Konkery/Project-8_2026-N2-HORIZON/03__Проект/ai-8_2026-n2-горизонт.md

# ЖУРНАЛ ПРОЕКТА 8/2026-N2-ГОРИЗОНТ

> **Назначение.** Append-only журнал работ сессии заказа **N2** рамочного договора
> `8/2026-N0-ГОРИЗОНТ`. Записи хронологически вниз; прошлые опечатки не правятся.
> Системный контекст: `..\..\8_2026-N0-Горизонт\AGENTS.md` (манифест рамки) +
> переходный промт `03__Проект\00__raw\ai-trans-order2.md`.
> Регламент ведения — манифест § 4 (по аналогии с журналом рамки
> `03__Проект\ai-8_2026-n0-горизонт.md`).

---

## 1. Промты

### 1.1 Переходный промт заказа N2 (перенос контекста из рамки 8/2026-N0)

#### _исходные данные:_

Сессия рамки `8/2026-N0-ГОРИЗОНТ` накопила полный контекст преддоговорной и
договорной работы (промты 0.1–1.10). Рамочный договор подписан исполнителем
20.10.2026 (ЭДО, версия заказчика `rev.01 v02` подписана ЭП 20.10.2026).
Работа по прикладным заказам переносится в директорию `8_2026-N2-Горизонт\`.
Переходный промт с полным перенесённым контекстом сохранён:
`03__Проект\00__raw\ai-trans-order2.md`.

#### _задача:_

1. Принять контекст рамки (манифест + переходный промт) как базовый системный
   контекст сессии заказа N2;
2. Завести настоящий журнал; далее вести работу заказа N2 в его директории,
   обращаясь к рамке N0 только за мастер-данными и документами общего цикла.

### 1.2 Создание манифеста заказа N2 (`AGENTS.md`)

#### _исходные данные:_

В директории заказа N1 уже сформирован манифест `..\8_2026-N1-Горизонт\AGENTS.md`
(v2.0) по образу манифеста рамки. Для заказа N2 собственный манифест отсутствует —
сессия опиралась только на манифест рамки и переходный промт.

#### _задача:_

Изучить переходный промт `03__Проект\00__raw\ai-trans-order2.md` и фактическое
содержимое ИРП заказа; создать `AGENTS.md` в корне `8_2026-N2-Горизонт\` по образу
и подобию манифеста рамки N0 (структура — как в манифесте N1), адаптировав под
специфику N2.

### 1.3 Актуализация план-графика и фиксация проекта в git (указание стороны)

#### _задача:_

1. Актуализировать `03__Проект\03__План-график\План_проекта_8_2026-N2_Horizon_VM.md`
   (120 к.д., ООО «ТМ ТЕХНОЛОГИЯ») — снять задачу 🎯 из манифеста § 9;
2. Выполнить коммит и push: все текущие файлы заказа должны отслеживаться
   (учитывая конвенции `.gitignore` и практики репозитория N1).

### 1.4 Фиксация подписания спецификации N2 и поступления аванса 1 (21.10.2026)

#### _исходные данные:_

Вечером 21.10.2026 (после 21:00) спецификация № 2 к рамочному договору подписана
со стороны исполнителя через ЭДО (версия заказчика подписана ЭП 20.10.2026
14:29 MSK; сверка версий выполнена 20.10.2026 — юридически значимых расхождений
нет, акцепт дословный). Ориентировочно в 12:00 (самарское время) 21.10.2026 по
счёту №2 от 20.10.2026 получен авансовый платёж 1 (55%).

#### _задача:_

1. Зафиксировать в проектной документации: с 21.10.2026 формально наступило
   время обязательств исполнителя по заказу N2 (День 0);
2. Синхронизировать статусы манифеста (§ 1.1, § 9) и план-графика (календарная
   привязка от Дня 0);
3. Коммит и push не выполнять — фиксация в git при более существенных изменениях
   (указание стороны).

### 1.4.1 Примечание к промту 1.4 (уточнение стороны от 21.10.2026)

Коммит и push по настоящей фиксации не выполняются — решение отложено до более
существенных изменений (указание Хозяина).

### 1.5 Разворачивание регламента переписки в проекте (26.10.2026)

#### _исходные данные:_

Сторона направила (двумя идентичными блоками) промт «ПЕРЕПИСКА В ПРОЕКТЕ»:
единое хранение `01__Документация\Переписка\` с каталогами `01__Входящие`,
`02__Исходящие`, `03__Третьи лица`, `04__Не официальная`; в каждом — `00__draft\`
для драфтов (по умолчанию markdown `…-draft.md`), выпущенный на бланке экземпляр —
в корень каталога; заглушки `README-mail-*.md` — реестры писем
(`Дата | Исх. № / файл | Тема письма | Контрагент | Статус`), хранящие реестровые
данные **единственно** в себе (в README/манифест — только путь); обязательная строка
`Тема письма:` под блоком реквизитов; агент готовит содержательную часть с
заглушками, человек — бланк/номер/ФИО/подпись; даты и суммы — только из
подписанных документов по первоисточнику; агент не выдумывает даты/номера
(без факта — статус «черновик»); цикл драфт → выпуск → подтверждение менеджера →
реестр → журнал; этика закрытой тематики и ролевых формулировок.

#### _задача:_

1. Развернуть структуру и реестры в заказе N2 с постановкой на учёт уже
   присутствующего выпущенного экземпляра исходящего письма;
2. Кодифицировать регламент в манифест `AGENTS.md` (связки § 7, новый § 10);
3. Зафиксировать факт в настоящем журнале; коммит/push — по отдельному указанию.

### 1.6 Драфт уведомления «О старте работ» для заказчика (26.10.2026)

#### _исходные данные:_

Указание стороны: подготовить информационное письмо заказчику о получении
аванса на р/с и приступлении к работам. Текст — по аналогии с заказом N1
(шаблон в промте: благодарность за подписание спецификации, зачисление аванса 1
с суммой и ссылкой на счёт/п. У.3.1, формулировка предмета работ, срок по п. У.7
календарными днями с датировкой финиша, напоминание об окне поставки образца
по п. У.4 с формой М15, уведомление об этапах по п. У.8). Имя файла драфта
задала сторона: `уведомление-начало-работ-draft.md`.

#### _задача:_

1. Перепроверить каждую цифру/пункт по первоисточнику — подписанному тексту
   Спецификации № 2 (п. 10 регламента § 10 манифеста);
2. Создать драфт в `01__Документация\Переписка\02__Исходящие\00__draft\`
   с блоком реквизитов-заглушек и строкой `Тема письма:`;
3. Внести строку в реестр `README-mail-out.md` со статусом «черновик»;
   закрыть часть задачи 8 § 9 манифеста (подготовка исправленного текста);
4. Запись в журнал; коммит/push — не выполнять.

### 1.7 Фиксация отправки письма М1, актуализация документации, git-фиксация (26.10.2026)

#### _исходные данные:_

Сторона сообщила: письмо «О старте работ» (Исх. № 8/2026-N2-Горизонт-M1 от
26.10.2026, PDF на бланке в корне `02__Исходящие\`) **отправлено через ЭДО**.
Проверка готового экземпляра по первоисточнику выполнена 26.10.2026 (по
указанию стороны): финансовые показатели верны (аванс 1 964 200,00 ₽,
НДС 354 200,00, счёт № 2 от 20.10.2026, п. У.3.1 Спец. № 2); модель
Knowhy G80/master корректна; зафиксировано расхождение написания модели ПТК
(«Horizon VM Post M80 rev.01» в письме против дословного
«HorizonVM Post M80 rev1» в спецификации) и отсутствие абзацев У.7/У.4/У.8
в отправленной версии; прежний docx-экземпляр с данными заказа N1 заменён.

#### _задача:_

1. Реестр `README-mail-out.md`: PDF — статус «отправлено» с датой; docx —
   «отозван»; драфт — снять с выпуска (отправлена сокращённая версия);
2. Манифест: задача 8 → ✅, версия 1.3;
3. Подготовить информативный коммит (включая перестройку ИРП стороной:
   реестр писем, каталог «ТМ Технология», закрытие старого блока
   «Точные машины», счета) и выполнить push.

---

## 4. Тема - Исполнение промтов (заказ N2)

### 4.1 Запись от 20.10.2026 — инициализация журнала заказа N2

#### _Ход работы:_

Создан переходный промт `03__Проект\00__raw\ai-trans-order2.md` (перенос
контекста цепочки заказов N1–N7, решений №1/№2, системы спецификаций, экономики
и статусов по состоянию на 20.10.2026) и настоящий журнал.

#### _Решение:_

1. журнал — append-only, структура повторяет журнал рамки (разделы промтов и
   записей исполнения);
2. ключевые зафиксированные факты переноса: рамочный договор подписан
   исполнителем 20.10.2026; заказчик — ООО «ТМ ТЕХНОЛОГИЯ» (все заказы N1–N7
   для него); подписание N1/N2/N3 одновременное через ЭДО.

#### _Проверки:_

Файлы созданы; пути переходного промта и журнала соответствуют ИРП заказа.

### 4.2 Запись от 20.10.2026 — создан манифест заказа N2

#### _Ход работы:_

Прочитаны: манифест рамки `..\8_2026-N0-Горизонт\AGENTS.md` (v1.8), переходный
промт `03__Проект\00__raw\ai-trans-order2.md`, журнал заказа, манифест-аналог
заказа N1 (`..\8_2026-N1-Горизонт\AGENTS.md`, v2.0) как шаблон структуры.
Проведена инвентаризация фактического содержания ИРП N2 (спецификации типов
30/40 и рабочие срезы 50–90, ТКП на ООО «ТМ ТЕХНОЛОГИЯ», счета, план-график,
ИД-материалы Wate, материалы контрагентов), проверен git-репозиторий заказа.

Создан `AGENTS.md` (корень `8_2026-N2-Горизонт\`), v1.0: § 1 паспорт заказа и
экономика (5 позиций, 120 к.д., 2 960 000,00 ₽ без НДС; аванс 1/2 и постоплата),
§ 2 роли/диалог/этика, § 3 система спецификаций, § 4 регламент разработки,
§ 5 дорожная карта и увязки (N2 → N3, перспективный N5), § 6 регламент
бизнес-процесса, § 7 реестр ИРП, § 8 внешние ссылки, § 9 статус и задачи.

#### _Решение:_

1. Структура и нормы наследуются от манифеста рамки; при расхождении приоритет —
   у манифеста рамки (§ назначение документа);
2. В § 1.2 добавлен callout о первичности абсолютных сумм платежей и о сверке
   реквизитов заказчика (расхождения подписанной v02);
3. В § 7 зафиксированы фактические артефакты, в том числе счёт №2 от 20.10.2026
   на ООО «ТМ ТЕХНОЛОГИЯ» (аванс 1) и ТКП sign/nosign;
4. В § 9 поставлена отдельная задача актуализации план-графика: текущая редакция
   `План_проекта_8_2026-N2_Horizon_VM.md` — 100 к.д. и прежний заказчик
   (ООО «Точные машины»), тогда как срок договора N2 — 120 к.д. от подписания.

#### _Проверки:_

`AGENTS.md` создан в корне заказа (160 строк по образцу N1); таблицы имеют
маркеры выравнивания; пути перепроверены по факту инвентаризации каталогов;
журнал дополнен записями 1.2 и 4.2 (append-only, исторические записи не
переписывались). Файлы спецификаций не изменялись (только чтение).

### 4.3 Запись от 20.10.2026 — актуализация план-графика и git-фиксация

#### _Ход работы:_

План-график переработан в редакцию rev.01 v02: срок 120 к.д. от даты подписания
(День 0), заказчик — ООО «ТМ ТЕХНОЛОГИЯ», основание — Решение №2 от 19.10.2026;
диаграмма Ганта пересобрана (Фаза 0 контрактация/аванс 1 1 964 200,00 ₽ с НДС;
Фаза 3 расширена до дней 95–118; Фаза 4 — постпроект), суммы платежей по
спецификации (аванс 1 — 1 610 000,00; аванс 2 — 1 000 000,00; постоплата —
350 000,00 без НДС); персоналии в матрице ответственности заменены ролевыми
формулировками (этика § 1.1); добавлен риск по реквизитам v02.

Манифест § 9: задача 3 → ✅. Git: `.gitignore` синхронизирован с практикой
репозитория N1; в индекс добавлены рабочие артефакты (типы 30/40, ТКП на
ТМ Технология, счета №2, ИД Wate (pdf), журнал, AGENTS.md, эскизы и документация
контрагентов); удалённые из рабочего дерева артефакты прежнего контрагента
сняты с отслеживания; переименование `ид-аппаратов-watt → wate` зафиксировано
как rename. Переходный промт остаётся в `00__raw/` вне git (правило `00__raw/`
в `.gitignore`, конвенция N1). Коммит с подробным сообщением, push в `origin main`.

#### _Решение:_

1. Спецификационные и платёжные артефакты фиксируются в git; рабочие каталоги
   `.*/`, `00__raw/` и медиа-фильтры (dwg/png/jpg/svg/mdb/dat/bak/mp4 и пр.) —
   по конвенции `.gitignore` репозитория-брата N1 (исторически коммитились до
   введения фильтров, новые выпуски не добавляются в обход фильтров);
2. Календарная привязка этапов — относительная (дни от Дня 0), до фиксации
   точной даты подписания N2 через ЭДО.

#### _Проверки:_

`git status` — рабочее дерево после коммита чисто (кроме игнорируемого);
`git push` — успешно (см. факт вывода); план-график читается, mermaid
gantt без синтаксических ошибок; суммы сверены с § 1.2 манифеста
(1 610 000,00 + 1 000 000,00 + 350 000,00 = 2 960 000,00 — сходится).

### 4.4 Запись от 21.10.2026 — подписание спецификации N2 и поступление аванса 1

#### _Ход работы:_

Зафиксировано: 21.10.2026 вечером (после 21:00) спецификация № 2 (заказ N2)
подписана со стороны исполнителя через ЭДО; версия заказчика подписана ЭП
директора 20.10.2026 14:29 (MSK), сверка версий — акцепт без юридически
значимых правок (см. сверку 20.10.2026). Ориентировочно в 12:00 самарского
времени 21.10.2026 получен авансовый платёж 1 по счёту №2 от 20.10.2026
(1 964 200,00 ₽ с НДС: база 1 610 000,00 + НДС 354 200,00).

Обновлены: манифест `AGENTS.md` (§ 1.1 строка подписания; § 9 — задачи 1/2/3
в текущих статусах, новая задача 6 старт исполнения, задача 7 ⚠️ по сроку);
план-график (календарная привязка от Дня 0 = 21.10.2026); настоящий журнал.

#### _Решение:_

1. **С 21.10.2026 формально наступило время обязательств исполнителя по заказу
   N2** — точка отсчёта (День 0) для целей планирования; фактические триггеры
   сроков по тексту спецификации: У.3 (аванс 1 в течение 3 раб. дней — исполнен
   поступлением), У.4 (передача образца заказчиком: окно 21–45 к.д. от зачисления
   аванса = ориентировочно 11.11–05.12.2026), У.7 (общий срок 140 к.д. с даты
   зачисления аванса 1 → ориентир завершения ~10.03.2027);
2. ⚠️ Выявлено при фиксации: срок по подписанной спецификации У.7 — **140 к.д.**,
   договорные сводные данные заказа (переходный промт, финансовая сводка цепочки) —
   **120 к.д.** Приоритет — у текста подписанной спецификации; расхождение
   эскалировано инженеру/стороне (в переписке — нейтральной формулировкой
   «уточнение исчисления срока»), в планировании до уточнения считать 140 к.д.;
3. Аванс 2 (33%, 1 220 000,00 ₽ с НДС) — в течение 30 календарных дней после
   подписания спецификации и выписки счёта (У.3 п.2) → ориентир до ~20.11.2026;
   контроль поступления;
4. Коммит/push не выполнялись (указание стороны); изменения в рабочем дереве.

#### _Проверки:_

Суммы сверены с текстом подписанной спецификации (У.3: 1 964 200 / 1 220 000 /
427 000 с НДС, Σ = 3 611 200,00 — сходится); даты-ориентиры вычислены от
21.10.2026 (21 к.д. → 11.11; 45 к.д. → 05.12; 140 к.д. → 10.03.2027;
подписание+30 к.д. → 20.11); файлы: `AGENTS.md` (2 правки секций), план-график
(привязка Дня 0), журнал (записи 1.4, 1.4.1, 4.4) — изменены; git-индекс не
трогался (`git status` — изменения в рабочем дереве, коммитов нет).

### 4.5 Запись от 26.10.2026 — развернут реестровый контур переписки

#### _Ход работы:_

Структура переписки заказа развернута по регламенту стороны (промт 1.5) и по
образу реестров репозитория-брата N1 (прочитаны `README-mail-in.md`,
`README-mail-out.md` N1). В `01__Документация\Переписка\` созданы четыре каталога
с заглушками-реестрами — `README-mail-in.md`, `README-mail-out.md`,
`README-mail-third.md`, `README-mail-unofficial.md` — и подкаталоги `00__draft\`
в каждом.

Принят на учёт ранее выпущенный экземпляр в `02__Исходящие\`: Исх. №
8/2026-N2-Горизонт-M1 от 26.10.2026, тема «О старте работ», контрагент
ООО «ТМ Технология» — внесён в реестр со статусом «выпущен (отправка не
подтверждена)». Текст письма прочитан через копию `%TEMP%` (оригинал занят
сессией Word): указаны счёт № 1, Спецификация № 1, аванс 1 543 700,00 ₽
(НДС 278 372,13) и старт работ по Заказу № 1 — это данные заказа N1;
для заказа N2 корректные: счёт № 2 от 20.10.2026, Спецификация № 2,
аванс 1 964 200,00 ₽ с НДС.

Манифест `AGENTS.md` дополнен: § 7 (строка ИРП `01__Документация/` — путь
к реестрам), § 9 (задача 8 ⚠️ — подтверждение отправки и сверка цифр
исходящего документа по первоисточнику), новый § 10 «ПЕРЕПИСКА» (сжатая
нормативная редакция регламента); версия 1.2 · 26.10.2026.

#### _Решение:_

1. Реестровые данные писем — только в `README-mail-*.md`; манифест и журнал
   ссылаются на реестры без переноса сведений (для журнала это исключение —
   протокол диалога);
2. ⚠️ M1 эскалирован менеджеру (задача 8): подтвердить дату/факт отправки;
   если не отправлен — подготовить исправленный драфт M1 под данные
   заказа N2 в `00__draft\` (статус реестра — «черновик»);
3. Пустые `00__draft\` git не индексирует (п. 3 регламента) — появятся
   в индексе с первым файлом;
4. Коммит/push не выполнялись (указание от 21.10.2026 сохраняет силу).

#### _Проверки:_

`os.walk` — 4 каталога, 4 реестра, 4 `00__draft\` (у `01__Входящие` каталог
драфтов досоздан после первой команды); реестровая строка M1 сверена с текстом
письма (№, дата 26.10.2026, тема — дословно); grep `AGENTS.md` — HTML-сущностей
нет, § 10 на месте, футер 1.2; журнал — записи 1.5 и 4.5, структура проверена
(`### 1.x` под `## 1`, единственный `## 4`); `git status` — изменения только
в рабочем дереве, коммитов нет.

### 4.6 Запись от 26.10.2026 — подготовлен драфт уведомления «О старте работ»

#### _Ход работы:_

Сверка по первоисточнику — извлечение текста подписанной Спецификации № 2
(`%TEMP%\opencode\spec-sign.txt`, PDF sign через pypdf): п. У.1 — предмет
(реверс-инжиниринг постаматного вендингового аппарата Knowhy G80/master,
адаптация ПТК «HorizonVM Post M80 rev1», передача ресурсов по форме М15),
п. У.2 — РИД (прикладное ПО уровня «User space»), п. У.3.1 — аванс 1
1 964 200,00 ₽ в т.ч. НДС 22% 354 200,00 ₽ (счёт № 2 от 20.10.2026),
п. У.4 — окно 21–45 к.д. от зачисления, шкаф «Knowhy G80» с полным комплектом
работоспособных актуаторов и сенсоров на все ячейки, п. У.7 — 140 к.д.,
п. У.8 — письменное уведомление по этапам + промежуточные результаты
за 3 раб. дня, п. У.10 — 443029, г. Самара, 6-я Просека, д. 144.

Даты вычислены методом письма N1 (зачисление + N к.д.): 140 → 10.03.2027
включительно; 21 → 11.11.2026; 45 → 05.12.2026. Контроль метода: N1 —
21.10 + 164 → 03.04.2027, +7/+14 → 28.10/04.11 — совпадает с выпущенным
письмом N1.

Создан `01__Документация\Переписка\02__Исходящие\00__draft\
уведомление-начало-работ-draft.md`: реквизиты-заглушки, `Тема письма:
О старте работ`, четыре пронумерованных блока (аванс/старт+срок/окно У.4+М15/
У.8), приложение и подписной блок заглушками, персоналии — прочерками
(заполняет человек на бланке). Реестр `README-mail-out.md` дополнен строкой
драфта (статус «черновик») и обновлён callout: драфт заменяет бланчный
экземпляр M1 при выпуске.

#### _Решение:_

1. Тема письма принята дословно «О старте работ» — ключ поиска в реестре,
   совпадает с существующим выпущенным экземпляром M1 (он же — объект
   задачи 8 § 9);
2. В письмо включен срок по п. У.7 — 140 к.д. (текст подписанной спецификации),
   формулировка с условием «при соблюдении п. У.3 и У.4» — как в шаблоне N1;
   расхождение 120/140 (задача 7) эскалируется отдельно, в письме не отражено;
3. Отправка — только после выпуска человеком; статус реестра изменять
   по факту отправки с датой.

#### _Проверки:_

Факт-лист спецификации: сумма 1 964 200,00 = 1 610 000,00 + 354 200,00 ✅
(сходится с НДС 22% от базы); Σ платежей У.3 = 3 611 200,00 ✅; адреса и номера
пунктов в драфте — дословно из извлечения ✅; файлы: драфт создан, реестр —
2 строки + callout ✅; журнал — записи 1.6 и 4.6, структура корректна ✅;
`git status` — без коммитов, индекс не трогался ✅.

### 4.7 Запись от 26.10.2026 — отправка письма М1 зафиксирована; документация актуализирована; git-фиксация с push

#### _Ход работы:_

Проверка готового экземпляра (PDF, извлечение через копию `%TEMP%`): п. 1 письма —
аванс 1 964 200,00 ₽ в т.ч. НДС 354 200,00 по счёту № 2 от 20.10.2026 (У.3.1
Спецификации № 2) — сходится с первоисточником и арифметикой (1 610 000 × 1,22);
п. 2 — Заказ № 2, Knowhy G80/master, ПТК «Horizon VM Post M80 rev.01» (в спецификации
дословно «HorizonVM Post M80 rev1») — модель и состав работ корректны, расхождение
написания учтено без искажения смысла; адресат и подписной блок соответствуют
подписанту ЭП заказчика. Финансовых ошибок и ошибок в сроках не выявлено
(сроки в отправленную версию не включены: абзацы У.7/У.4/У.8 драфта отсечены).

Реестр `README-mail-out.md`: три строки — PDF «отправлено (26.10.2026, ЭДО)»,
первый docx «отозван (данные заказа N1)», драфт «черновик (не выпущен)»;
callout заменён на итоги сверки. Манифест: задача 8 → ✅, версия 1.3 · 26.10.2026.

Git: индексация всей ИРП с учётом перестройки стороной — добавлены каталоги
`01__Документация\` (реестры переписки, экземпляры М1, драфт),
`02__Спецификации\01__Заказы\`, `03__Проект\77__Контрагенты\02__ТМ Технология\`;
файлы прежнего блока «Точные машины\03__Out» (3 PDF) перемещены стороной в новый
реестр — git зафиксировал их как rename; обновлены счета (`05__Счета\02__Исходящие\`), план-график (v03),
манифест (v1.3), журнал. `00__raw/` и медиа-фильтры — по `.gitignore` (конвенция N1).
Коммит с подробным сообщением, push в `origin main` — выполнены (указание стороны).

#### _Решение:_

1. Отправка М1 подтверждена стороной 26.10.2026 — статус «отправлено» внесён
   в реестр по факту сообщения менеджера (п. 7 регламента);
2. Расхождение написания модели ПТК в переписке не корректируется (письмо
   отправлено); при следующих выпусках — дословное «HorizonVM Post M80 rev1»;
3. Напоминание по У.4 (окно 11.11–05.12.2026, форма М15) выносится отдельным
   письмом ближе к открытию окна — в реестре планируется новая строка;
4. Задача 7 (140 vs 120 к.д.) остаётся ⚠️ до ответа заказчика.

#### _Проверки:_

`git log -1` — новый коммит поверх `f19abf1`; `git status` после коммита — чисто
(кроме игнорируемого); `git push` — успешно (вывод remote); реестр — 3 строки,
заголовки таблиц с маркерами выравнивания; манифест — задача 8 ✅, футер 1.3;
журнал — записи 1.7 и 4.7, структура корректна (`### 1.x` под `## 1`,
единственный `## 4`).

---
