Konkery/Project-8_2026-N2-HORIZON/03__Проект/03__План-график/План_проекта_8_2026-N2_Horizon_VM.md

# КОМПЛЕКСНЫЙ ПЛАН РЕАЛИЗАЦИИ ПРОЕКТА 8_2026-N2

## «Линейка промышленных вендинговых аппаратов Horizon VM на базе платформы Horizon Automation»

**Заказчик:** ООО «ТМ ТЕХНОЛОГИЯ»
**Исполнитель:** ООО «ГОРИЗОНТ»
**День 0:** **21.10.2026** — спецификация № 2 подписана сторонами (исполнитель — вечером 21.10.2026) и получен авансовый платёж 1 (ориентировочно 12:00 самарского времени). С 21.10.2026 — формально наступило время обязательств исполнителя
**Базовый срок проекта:** 120 календарных дней от Дня 0; **по тексту подписанной спецификации п. У.7 — 140 календарных дней с даты зачисления аванса 1** (расхождение уточняется, планирование — от консервативных 140 к.д. → ориентир завершения ~09.03.2027)
**Основание:** рамочный договор `8/2026-N0-ГОРИЗОНТ` (подписан исполнителем 20.10.2026), спецификация № 2 (заказ N2) от 20.10.2026 — акцептована и подписана 20–21.10.2026, Решение №2 заказчика от 19.10.2026 (одновременное подписание N1/N2/N3 через ЭДО), спецификация типа 40 (5 позиций, макроблок `2.x`)
**Горизонт планирования:** Опытно-промышленная адаптация (Головной образец) → Подготовка к серийному производству.

> ⚠️ **Важно:** календарные ориентиры: аванс 2 (п. У.3.2, 30 к.д. от подписания/счёта) —
> ориентировочно до 20.11.2026; передача образца заказчиком (п. У.4) — окно
> **11.11–05.12.2026**; этапы Фазы 1 стартуют с фактической передачи образца.
> План-график актуализирован 20.10.2026 (ред. rev.01 v02), привязка Дня 0 —
> 21.10.2026 (ред. v03); история не переписывается — правки зафиксированы
> в журнале проекта.

---

## 1. ДОРОЖНАЯ КАРТА ПРОЕКТА (ROADMAP)

```mermaid
gantt
    title Проект 8_2026-N2: День 0 = 21.10.2026, лимит У.7 = 140 к.д.
    dateFormat  X
    axisFormat День %d

    section Фаза 0. Контрактация
    Подписание спец. N2 через ЭДО (исполнитель 21.10) :done, f0_0, 0, 1
    Аванс 1 получен (21.10.2026 ~12:00 сам.)         :done, f0_1, 0, 1
    Приёмка образца в окне У.4 (11.11–05.12)        :f0_2, 21, 45

    section Фаза 1. Инжиниринг и ТЗ (от передачи образца)
    Этап 1.1 Реверс-инжиниринг и обмер образца :f1_1, 45, 58
    Этап 1.2 Разработка ТЗ №1 (Изделие в целом):f1_2, 58, 65
    Этап 1.3 Разработка ТЗ №2 (Адаптация ПТК)  :f1_3, 65, 72

    section Фаза 2. Разработка и сборка ПТК (дни 45–115)
    Закупка покупных комплектующих (ВП)        :f2_1, 45, 75
    Разработка схемотехники и плат управления  :f2_2, 72, 92
    Разработка Firmware и модулей АСУ          :f2_3, 78, 102
    Сборка и стендовая отладка ПТК             :f2_4, 102, 115

    section Фаза 3. Монтаж, ПНР и Испытания (дни 115–140)
    Монтаж ПТК в образец вендинга              :f3_1, 115, 121
    Сквозная отладка ПО и интеграция с 1С      :f3_2, 121, 128
    Комплексные испытания и сдача работ        :f3_3, 128, 140

    section Фаза 4. Серийное производство (постпроект)
    Подготовка комплекта РКД и стандартов      :f4_1, 130, 150
    Калькуляция и запуск серийной партии       :f4_2, 138, 160
```

---

## 2. ДЕТАЛЬНЫЙ ПОЭТАПНЫЙ ПЛАН

### Фаза 0. Организационно-договорной блок (Дни 0–45, закрыт частично)

* **0.1.** ✅ Подписание спецификации N2 через ЭДО — со стороны исполнителя 21.10.2026 (вечер, после 21:00); версия заказчика подписана ЭП 20.10.2026 14:29 (MSK). Одновременный обмен экземплярами N1/N3 (Решение №2 от 19.10.2026) — на контроле. Приложение — спецификации типов 30/40 на ООО «ТМ ТЕХНОЛОГИЯ» (перегенерация типов — за инженером после корректировки мастера `work spec`).
* **0.2.** ✅ Счёт на аванс 1: **1 610 000,00 ₽ без НДС** (НДС 354 200,00; **с НДС 1 964 200,00 ₽**) — счёт №2 от 20.10.2026 (`05__Счета\02__Исходящие\`). **Аванс 1 получен ориентировочно 12:00 (самарское время) 21.10.2026** — Дата исполнения обязательств: 21.10.2026.
* **0.3.** 🎯 Приёмка давальческого образца аппарата постаматного типа (80 ячеек) на производственной площадке ООО «Горизонт» (г. Самара, 6-я Просека, 144) — по п. У.4 заказчик передаёт в окне **21–45 к.д. от зачисления аванса 1 = 11.11–05.12.2026**.
* **0.4.** Оформление Акта приема-передачи оборудования на ответственное хранение — с фактической даты приёмки образца (0.3).
* **0.5.** 🔄 Аванс 2: **1 000 000,00 ₽ без НДС** — по п. У.3.2 в течение 30 к.д. после подписания спецификации и выставления счёта (ориентир — до 20.11.2026). Постоплата **350 000,00 ₽ без НДС** — по факту приёмки работ (акт сдачи-приёмки).

---

### Фаза 1. Предпроектный анализ, реверс-инжиниринг и ТЗ (Дни 45–72 / 27 дней, от фактической передачи образца)

#### Этап 1.1: Инженерный анализ конструкции и электроники (13 дней)

* Анализ габаритных и посадочных мест постаматной секции, кабельных трасс, блока замков.
* Реверс-инжиниринг штатных модулей управления, схем концевых датчиков и приводов запирания.
* Сопоставление с наработками Заказа №1 (ПТК `MAS-n1701-F1757N001-VMhyb-01` для N96 Main Box).
* **Результат:** Технический отчет о выявленных конструктивных и схемотехнических отличиях.

#### Этап 1.2: Разработка Технического задания №1 на Изделие в целом (7 дней)

* Формирование требований к эргономике, электропитанию (220В, ИБП), интерфейсу пользователя (Touchscreen, RFID, QR-сканер).
* Определение эксплуатационных требований (температурный режим цеха, защита от пыли/влаги).
* **Результат:** Утвержденное ТЗ №1 на вендинговый аппарат «Horizon VM-80».

#### Этап 1.3: Разработка Технического задания №2 на адаптацию ПТК (7 дней)

* Формирование перечня аппаратных модулей АСУ «Horizon Automation» (контроллеры, драйверы замков, датчики).
* Определение реестра программных изменений (firmware микроконтроллеров, терминальный софт).
* **Результат:** Утвержденное ТЗ №2 на адаптацию ПТК.

---

### Фаза 2. Проектирование, комплектование и сборка ПТК (Дни 45–115, частично параллельно Фазе 1)

#### 2.1. Аппаратная часть и схемотехника:

* Проектирование и изготовление коммутационных плат сопряжения для матрицы 80 ячеек.
* Комплектование промышленного вычислительного модуля, блока вторичного питания, цепей защиты и интерфейсов RS-485 / Industrial Ethernet.
* Закупка покупных изделий (сенсорный дисплей, считыватель Mifare/EM-Marin, 2D-сканер, датчики).

#### 2.2. Программный комплекс «Horizon Automation»:

* **Нижний уровень (Firmware):** разработка прошивки контроллера управления замками с защитой от одновременных токовых перегрузок и контролем концевиков.
* **Средний/Верхний уровень:** адаптация терминального ПО оператора (выдача, возврат, учет инструмента, аварийные сценарии).
* **СУБД и интеграция:** локальное хранилище транзакций + REST API / MQTT коннекторы к 1С:ERP Заказчика.

#### 2.3. Сборка и стендовое тестирование ПТК:

* Сборка шкафа/блока АСУ «Horizon VM».
* Стендовое тестирование каналов управления, стресс-тест драйверов замков (имитация 80 ячеек).
* **Результат:** Готовый к монтажу головной комплект ПТК «Horizon VM».

---

### Фаза 3. Монтаж, ПНР и комплексные испытания (Дни 115–140 / 25 дней, финаль У.7)

#### Этап 3.1: Комплексное тестирование и сдача

* Монтаж адаптированного ПТК в штатный корпус аппарата, прокладка жгутов, подключение замков.
* Настройка и калибровка датчиков положения ячеек.
* Развертывание ПО «Horizon Automation», проведение тестовых циклов авторизации, выдачи и возврата инструмента.
* Проведение приемо-сдаточных испытаний (ПСИ) в присутствии представителя Заказчика.
* **Результат:**
  1. Протокол комплексных испытаний.
  2. Откорректированное прикладное ПО всех уровней.
  3. Акт готовности изделия к эксплуатации и финальный Акт сдачи-приемки.
* Acceptance процедуры N2 — эталон для выездной приёмки парка в N3 (совместно с заказчиком, Решение №2 от 19.10.2026).

---

### Фаза 4. Стандартизация и серийное производство «Horizon VM» (Параллельно / Постпроект)

* **4.1.** Выпуск комплекта рабочей конструкторской документации (РКД) на комплект модернизации.
* **4.2.** Разработка инструкций по монтажу, пусконаладке и регламентному техническому обслуживанию.
* **4.3.** Формирование коммерческих предложений на поставку серийных партий аппаратов «Horizon VM» и комплектов дооснащения парка Заказчика.
* Методика «реверс-инжиниринг → адаптация ПТК» транслируется в **N3** (парк Wate, 6 моделей) и перспективный **N5** (объединённый N1+N4 для G80).

---

## 3. МАТРИЦА ОТВЕТСТВЕННОСТИ И РОЛЕЙ

| Роль в проекта | Зона ответственности |
| :--- | :--- |
| **Куратор проекта / Главный конструктор (исполнитель)** | Общее руководство, утверждение ТЗ, архитектура АСУ «Horizon Automation», взаимодействие с руководством заказчика |
| **Инженер-схемотехник / АСУ ТП (исполнитель)** | Реверс-инжиниринг, разработка плат сопряжения, комплектование ПТК, стендовые испытания |
| **Ведущий разработчик ПО (исполнитель)** | Микропрограммы контроллеров, прикладное терминальное ПО, протоколы интеграции с 1С/ERP |
| **Инженер-конструктор / Механика (исполнитель)** | 3D-моделирование, посадочные места, кабельные трассы, подготовка КД |
| **Куратор со стороны Заказчика** | Передача образца, согласование ТЗ, предоставление тестовых карт СКУД/ТМЦ, участие в ПСИ |

---

## 4. АНАЛИЗ РИСКОВ И МЕРЫ СНИЖЕНИЯ

| Риск | Влияние | Вероятность | Мера снижения / План реагирования |
| :--- | :---: | :---: | :--- |
| **Задержка поставки образца аппарата** | Высокое | Низкая | Фиксация в договоре старта этапов только с даты фактической передачи образца |
| **Специфические протоколы китайских плат замков** | Среднее | Средняя | Использование универсальных драйверов «Horizon Automation» прямой коммутации замков в обход китайских микросхем |
| **Длительный срок поставки импортных электронных компонентов** | Среднее | Низкая | 90% компонентов ПТК подобраны из складских запасов в РФ и отечественных аналогов |
| **Несовместимость с корпоративной СКУД Заказчика** | Низкое | Низкая | Запрос тестовых карт и образцов ридеров на раннем этапе (Этап 1.1) для тестирования мультиформатных считывателей |
| **Расхождения подписанной версии рамки (реквизиты v02)** | Среднее | Средняя | Платёжные и адресные документы — по сверенным реквизитам; при необходимости уточняющее письмо/соглашение (отчёты сверки рамки) |

---

## 5. БЛИЖАЙШИЕ ДЕЙСТВИЯ (NEXT ACTIONS)

1. **[Стороны]** Обмен подписанными экземплярами N1/N3 через ЭДО (N2 — спецификация подписана исполнителем 21.10.2026 ✅); приложение — спецификации типов 30/40 на ООО «ТМ ТЕХНОЛОГИЯ».
2. **[Исполнитель]** ✅ Счёт на аванс 1 (1 964 200,00 ₽ с НДС) выставлен 20.10.2026; **аванс 1 поступил ~12:00 (сам.) 21.10.2026** — обязательства исполнителя действуют с 21.10.2026 (День 0).
3. **[Заказчик]** Отправка образца вендинга (постамат, 80 ячеек) на площадку в г. Самара — окно п. У.4: **11.11–05.12.2026** (21–45 к.д. от зачисления аванса 1); приёмка — с Актом на ответственное хранение.
4. **[Исполнитель]** Формирование рабочей группы, подготовка стенда и методики реверс-инжиниринга — к дате фактической передачи образца (старт Этапа 1.1).
5. **[Заказчик/Исполнитель]** Аванс 2 (1 000 000,00 ₽ без НДС) — по п. У.3.2 в течение 30 к.д. от подписания спецификации и выставления счёта (ориентир до 20.11.2026); контроль поступления.
6. **[Исполнитель]** ⚠️ Уточнение срока с заказчиком: п. У.7 подписанной спецификации — 140 к.д. с даты аванса 1 (финиш ~10.03.2027) против сводных 120 к.д.; планирование ведётся от 140 к.д., переписка — нейтральной формулировкой.

---
**Редакция:** rev.01 v03 · **Дата актуализации:** 21 октября 2026 г. (День 0, привязка к окну У.4 и лимиту У.7 140 к.д.) · **Предыдущие редакции:** v02 — 120 к.д. от подписания; v01 — 100 к.д., заказчик прежнего контура (история — в git и журнале проекта)
