Konkery/Project-8_2026-N2-HORIZON/01__Документация/Переписка/01__Входящие/README-mail-in.md

# README-mail · 01__Входящие

Каталог официальных писем, полученных от заказчика (ООО «ТМ ТЕХНОЛОГИЯ»).
Выпущенные экземпляры — в корне каталога; драфты — в `00__draft\`.
Регламент ведения переписки и реестра — `AGENTS.md` § 10.
Реестровые данные конкретных писем хранятся **только здесь**.

## Реестр входящих писем

| Дата | Вх. № / файл | Тема письма | Контрагент | Статус |
| :--- | :--- | :--- | :--- | :--- |
