Konkery/Project-8_2026-N2-HORIZON/01__Документация/Переписка/02__Исходящие/README-mail-out.md

# README-mail · 02__Исходящие

Каталог официальных писем исполнителя (ООО «ГОРИЗОНТ») заказчику.
Содержательная часть готовится в `00__draft\` (markdown, `…-draft.md`);
выпущенный на бланке экземпляр сохраняется в корне каталога.
Регламент ведения переписки и реестра — `AGENTS.md` § 10.
Реестровые данные конкретных писем хранятся **только здесь**.

## Реестр исходящих писем

| Дата | Исх. № / файл | Тема письма | Контрагент | Статус |
| :--- | :--- | :--- | :--- | :--- |
| 26.10.2026 | 8/2026-N2-Горизонт-M1 · `Письмо-ТМ Технология - О старте работ - № 8_2026-N2-Горизонт-M1.pdf` | О старте работ | ООО «ТМ Технология» | отправлено (26.10.2026, ЭДО) |
| 26.10.2026 | 8/2026-N2-Горизонт-M1 (первый экземпляр) · `00__draft\Письмо-ТМ Технология - О старте работ - № 8_2026-N2-Горизонт-M1.docx` | О старте работ | ООО «ТМ Технология» | отозван (данные заказа N1; заменён PDF) |
| 26.10.2026 | драфт к Исх. № 8/2026-N2-Горизонт-M1 · `00__draft\уведомление-начало-работ-draft.md` | О старте работ | ООО «ТМ Технология» | черновик (не выпущен; отправлена сокращённая версия) |

> ⚠️ **Важно:** отправленный PDF-экземпляр сверен с первоисточником (Спецификация № 2,
> п. У.3.1/У.1): сумма аванса 1 964 200,00 ₽ (НДС 354 200,00), счёт № 2 от 20.10.2026,
> Knowhy G80/master — корректны. Написание модели ПТК в письме «Horizon VM Post
> M80 rev.01» расходится с дословным «HorizonVM Post M80 rev1» в спецификации
> (учтено, ошибок не влечёт). Абзацы п. У.7/У.4/У.8 в отправленную версию не вошли.
