Konkery/Project-8_2026-N2-HORIZON/01__Документация/Переписка/03__Третьи лица/README-mail-third.md

# README-mail · 03__Третьи лица

Каталог официальных писем с третьими лицами проекта (соисполнители, поставки,
подряды). Выпущенные экземпляры — в корне каталога; драфты — в `00__draft\`.
Регламент ведения переписки и реестра — `AGENTS.md` § 10.
Закрытая тематика в исходящих документах не раскрывается.

## Реестр писем с третьими лицами

| Дата | Исх./Вх. № / файл | Тема письма | Контрагент | Статус |
| :--- | :--- | :--- | :--- | :--- |
