Konkery/Project-8_2026-N2-HORIZON/01__Документация/Переписка/04__Не официальная/README-mail-unofficial.md

# README-mail · 04__Не официальная

Каталог неофициальной переписки сторон: почтовая и мессенджерная
корреспонденция, резюме созвонов, договорённости без бланка. Драфты — в `00__draft\`.
Регламент ведения переписки и реестра — `AGENTS.md` § 10.
Реестровые данные хранятся **только здесь**.

## Реестр неофициальной переписки

| Дата | Файл / запись | Тема | Контрагент | Статус |
| :--- | :--- | :--- | :--- | :--- |
