Konkery/Project-8_2026-N2-HORIZON/01__Документация/Переписка/02__Исходящие/00__draft/уведомление-начало-работ-draft.md

# ДРАФТ · Уведомление о начале работ (заказ N2)

> Статус: черновик (реестр `README-mail-out.md`). Бланк, фактический исходящий
> номер, ФИО адресата и подпись — при выпуске человеком.
> Цифры и формулировки сверены с подписанным текстом Спецификации № 2 (ЭДО).

---

**Исх. № ______ от 26.10.2026**
**Кому:** Директору ООО «ТМ ТЕХНОЛОГИЯ» ____________________ (ФИО)
**Основание:** Спецификация № 2 от 20.10.2026 (Заказ № 2) к рамочному договору № 8/2026-N0-ГОРИЗОНТ; п. У.3.1 (первый авансовый платёж)

**Тема письма: О старте работ**

## О старте работ

Уважаемый(ая) ____________________!

Благодарим за подписание Спецификации № 2 со стороны Заказчика (20.10.2026) и подтверждаем следующее.

1. 21 октября 2026 г. на расчётный счёт Исполнителя поступил авансовый платёж
   в размере **1 964 200,00 руб.** (в том числе НДС 22% — 354 200,00 руб.)
   по счёту № 2 от 20.10.2026 — в соответствии с п. У.3.1 Спецификации № 2.
   Обязательства Заказчика по авансированию считаются исполненными.

2. Исполнитель приступил к выполнению работ по Заказу № 2 — реверс-инжиниринг
   постаматного вендингового аппарата **Knowhy G80/master** с адаптацией ПТК
   **«HorizonVM Post M80 rev1»** (результат — полнофункциональный прототип;
   согласно п. У.2 Исполнитель создаёт РИД — прикладное ПО уровня «User space»).
   Общий срок выполнения работ по п. У.7 составляет **140 календарных дней**
   с даты зачисления аванса, то есть — **по 10.03.2027 включительно**
   (при соблюдении п. У.3 и У.4 Спецификации № 2).

3. Напоминаем, что по п. У.4 Заказчик обеспечивает доставку материальных
   ресурсов — один экземпляр вендингового шкафа «Knowhy G80» с полным комплектом
   работоспособных актуаторов и сенсоров на все ячейки — на производственную
   площадку Исполнителя (**443029, г. Самара, 6-я Просека, д. 144**) в срок
   **с 11.11.2026 по 05.12.2026 включительно** (21–45 календарных дней
   с даты зачисления аванса); передача оформляется составлением формы **М15**
   (п. У.1, У.4).

4. О завершении каждого этапа работ Исполнитель будет уведомлять Заказчика
   письменно (п. У.8); промежуточные результаты предоставляются по требованию
   Заказчика в течение 3 рабочих дней с даты получения запроса.

**Приложение:** не прилагается.

С уважением,
генеральный директор ООО «ГОРИЗОНТ»  ____________________ (ФИО)

Исп. ____________________  тел./e-mail: ____________________
