Konkery/Project-8_2026-N2-HORIZON/02__Спецификации/03__ТКП/02__Участники/Спецификация-№ 2 - Точные машины #08_2026-n2-горизонт.docx

Приложение №2

к договору № 8/2026
от «01» сентября 2026

Спецификация № 2

«01» сентября 2026

№ ЭТАПА | НАИМЕНОВАНИЕ ЭТАПА | РЕЗУЛЬТАТ РАБОТ ПО ЭТАПУ | СТОИМОСТЬ | ДЛИТЕЛЬНОСТЬ ВЫПОЛНЕНИЯ ЭТАПА, ДНЕЙ
1.1 | Инженерный анализ существующей конструкции постаматного вендингового аппарата | Изучение конструкционных, функциональных характеристик существующего аппарата. Получение списка характеристик, отличающих его от модели "Knowhy" модель N96 Main Box в части постаматной секции, актуаторов, сенсоров и системы управления. Результатом работ по этапу является: - облегченный технический отчет о выявленных качественных и количественных отличиях от модели "Knowhy" модель N96 Main Box в части организации управления постаматной секции. | 160 500,00 | 13
1.2 | Разработка ТЗ №1 на изделие в целом | Определение функциональных, технических требований к изделию в целом. Проработка списка требуемых корректируемых разделов, требуемых для адаптации ранее разработанного ПТК. Результатом работ по этапу является: - утвержденное ТЗ №1 на Изделие, содержащее перечень функциональных, технических требований. | 32 100,00 | 7
1.3 | Разработка ТЗ №2 на адаптацию ПТК к данной модели | ТЗ на определения реестра технических и организационных мероприятий, нацеленных на адаптацию ранее разработанного (для модели "Knowhy" модель N96 Main Box) ПТК для управления Изделием. Результатом работ по этапу является: - утвержденное ТЗ №2, на адаптацию ПТК. | 32 100,00 | 7
2.1 | Адаптация, комплектование и сборка ПТК в соответствии с ТЗ №2 | Комплектование и сборка ПТК, адаптированного для управления Изделием. Результатом работ по этапу является: - полнофункциональный укомплектованный ПТК для управления изделием. | 1 819 000,00 | 60
3.1 | Комплексное тестирование аппарата на базе новой системы управления | Комплексные испытания одного аппарата с обновленным набором сенсоров, актуаторов и новой системы управления. Результатом работ по этапу является: - протокол комплексных испытаний; - откорректированное на основе тестов прикладное ПО всех уровней, прошедшее проверку реализованной функциональности; - акт готовности изделия к эксплуатации. | 374 500,00 | 13
ИТОГО | | | 2 418 200,00 | 100

УСЛОВИЯ:

У.1

Данная Спецификация является калькуляцией работ по Заказу №2 от 13.07.2026. Предложение определяет перечень работ по проекту - Адаптация ПТК "MAS-n1701-F1757N001-VMhyb-01" и АСУ для управления вендинговым аппаратом постаматного типа бренда "Knowhy". Версия ПТК "MAS-n1701-F1757N001-VMhyb-01", была ранее разработана в рамках Заказа №1 и предназначалась для управления гибридным типом вендинговым аппаратом "Knowhy" модель N96 Main Box. Как и ранее разработанный ПТК, новая, адаптированная версия ПТК и АСУ должны реализовываться на базе российской платформы «Horizon Automation».
Для выполнения работ Заказчик передает Исполнителю на давальческой основе, работоспособный образец вендингового аппарата на все время проведения Работ. Заказчик обязуется доставить образец на производственную площадку Исполнителя. По окончанию работ Заказчик своими силами забирает образец вендингового аппарата с площадки Исполнителя, если стороны не договорятся об ином. Перечень работ, представленный в Спецификации, не предусматривает проектирования и/или перепроектирование существующей металлоконструкции аппарата и разработки соответствующей конструкторской документации.

У.2

В результате выполнения Работ по данной Спецификации Исполнитель создает РИД:
У.2.1 Прикладное ПО нижнего уровня системы управления изделием, в соответствии с п. 2.1 спецификации.
У.2.2 Прикладное ПО среднего уровня системы управления изделием, в соответствии с п. 2.1 спецификации.
У.2.3 Прикладное ПО отвечающее за взаимодействие нижнего и среднего уровней системы управления изделием, в соответствии с п. 2.1 спецификации.
У.2.4 Прикладное ПО отвечающее за взаимодействие среднего и верхнего уровней системы управления изделием, в соответствии с п. 2.1 спецификации.



Исполнитель передает Заказчику исключительное право на перечисленные 4 (четыре) компонента с момента подписания Сторонами Акта сдачи-приемки выполненных работ (Приложение №3 к Договору) и оплаты всех выполненных работ по Спецификации. Исключительное право на перечисленные РИД передается Заказчику для установки на интеллектуальное оборудования вендингового аппарата, с целью его использования по своему усмотрению.
Разработка прикладного ПО ведется на базе платформы автоматизации "Horizon Automation", на языке программирования JavaScript, серверной среды Node.js и среды потокового программирования Node-Red. Для работы прикладного программного обеспечения требуется программное обеспечение, относящееся к классу "Open source". Права на все компоненты "Horizon Automation" принадлежат ООО "Горизонт" и не передаются Заказчику в рамках настоящего Договора, права на программное обеспечение класса "Open source" принадлежит третьим лицам и права на него не передаются Заказчику в рамках настоящего Договора.
Реестр используемого платформой "Horizon Automation" программного обеспечения класса "Open source":
- Node.js – серверная исполнительная среда исполнения программ JavaScript;
- Node-Red - среда потокового программирования и визуализации;
- MongoDB – NoSQL СУБД, документо-ориентированная;
- Redis - NoSQL СУБД ,структурированных хранилищ данных в памяти;
- Graylog - сервер логирования и предоставления метрик;
- Grafana - среда визуализация метрик с подсистемой алертов;
- Mosquitto - брокер MQTT;
- MQTTX - web клиент MQTT;
- Traefik - реверс прокси;
- Dnsmasq – DHCP и DNS сервер;
- NTP - сервер точного времени.
Данный реестр является актуальным на момент подписания Спецификации, при выполнении Работ Исполнитель может расширить или сократить текущий список используемых программных компонентов класса "Open source". Уточненный список используемых компонентов класса "Open source" будет представлен Заказчику по окончанию работ при передаче исходных кодов прикладного программного обеспечения.
У.3 | Условия оплаты: оплата осуществляется Заказчиком в 2 этапа: - авансовый платеж в размере 2 043 700,00 руб. (два миллиона сорок три тысячи семьсот рублей 00 копеек), перечисляется на счет Исполнителя в течение 3 (трех) рабочих дней после подписания Спецификации и выписки Счета; - окончательный расчет в размере 374 500,00руб. (триста семьдесят четыре тысячи пятьсот рублей 00 копеек) в течение 7 рабочих дней после подписания Акта выполненных работ.
У.4 | Цены на Работы являются фиксированными и могут быть изменены только по соглашению Сторон.
У.5 | Заказчик обязан принять выполненные работы и товары, возврат авансовых платежей Заказчику не производится, никакие проценты за пользование Исполнителем денежными средствами, в соответствии со ст. 317.1., ст. 395 ГК РФ и иные проценты не начисляются.
У.6 | Общий срок оказания услуг по всем этапам составляет: 100 календарных дней с даты зачисления аванса на р/с, при соблюдении графика платежей и передачи Исполнителю образца вендингового аппарата не позднее 7 календарных дней с момента поступления аванса.
У.7 | Исполнитель письменно уведомляет Заказчика о завершении каждого этапа, предусмотренного настоящей Спецификацией, и по требованию Заказчика обязуется предоставить промежуточные результаты Работ/Услуг для проверки в течение 3 (трех) рабочих дней с даты получения запроса.
У.8 | Гарантийный срок на Результат Работ/Услуг составляет 12 (двенадцать) месяцев с даты подписания Акта сдачи-приемки.
У.9 | Адрес производственной площадки Исполнителя: 443029 г. Самара, 6-я Просека, д. 144
У.10 | Стоимость указана с НДС.
У.11 | Условия, представленные в Спецификации, действуют до 31.07.2026, в случае не акцептования Спецификации, необходимо запросить обновленную версию Спецификации.
У.12 | Представители Сторон:
| От Заказчика: Сидоров Семен Евгеньевич, Заместитель директора Департамента "Инструмент", Тел.: +7 963 856-21-31, e-mail: ss@tm96.ru | От Исполнителя Кукушкин Иван Николаевич, Генеральный директор, Тел.: +7 917 119-05-01, e-mail: ivan.kukushkin@mas-tech.ru

ЗАКАЗЧИК: ООО «Точные машины» Фактический адрес: 620078, г. Екатеринбург, ул. Педагогическая, 8А, офис 23 Тел.: +7 962 312-22-68, Юридический адрес: 620078, г. Екатеринбург, ул. Педагогическая, 8А, офис 23 ОГРН 1106670007180 ИНН 6670286290 КПП 667001001 Банк получателя: ФИЛИАЛ "ЕКАТЕРИНБУРГСКИЙ" АО "АЛЬФА-БАНК" г. Екатеринбург Р/с 40702810638060002019 К/С 30101810100000000964 БИК 046577964 Электронная почта: site@tm96.ru | | ИСПОЛНИТЕЛЬ: ООО «Горизонт» Фактический адрес: 443050, г. Самара, ул. Бугурусланская, д.81 Тел. +7 917 119-05-01 Юридический адрес: 443050, г. Самара, ул. Бугурусланская, д.81 ОГРН 1236300029426 ИНН 6312217507 КПП 631201001 Банк получателя: ПАО «СБЕРБАНК» Р/с 40702810854400007922 К/с 30101810200000000607 БИК 043601607 Электронная почта: info@mas-tech.ru
Директор _____________________Е.А. Приходько | | Генеральный директор ______________________И.Н. Кукушкин

_____________________Е.А. Приходько ______________________И.Н. Кукушкин Страница 2 из 2
