Konkery/Project-8_2026-N2-HORIZON/02__Спецификации/03__ТКП/02__Участники/00__draft/Спецификация-№ 2 - ТМ Технология #08_2026-n2-горизонт.docx

Приложение №2

к договору № 08/2026
от «01» сентября 2026

Спецификация № 2

«20» октября 2026

№ | НАИМЕНОВАНИЕ | ОПИСАНИЕ И ХАРАКТЕРИСТИКИ | ЕД ИЗМ. | КОЛ-ВО | ЦЕНА БЕЗ НДС, руб | СТОИМОСТЬ БЕЗ НДС, руб | НДС, руб | ДЛН, дней
2.101.1 | Инженерный анализ существующей конструкции изделия. Постаматный вендинговый аппарата, модель «Knowhy» G80/master | Изучение конструкционных, функциональных характеристик Изделия. Получение параметров характеристик. Результатом работ по этапу является: - внутренний технический отчет о выявленных качественных и количественных особенностях данной модели Изделия. | шт | 1 | 150 000,00 | 150 000,00 | 33 000,00 | 14
2.101.2 | Разработка ТЗ №1 на изделие в целом. Постаматный вендинговый аппарата, модель «Knowhy» G80/master | Определение функциональных, технических требований к изделию в целом. Проработка списка корректируемых разделов, требуемых для адаптации ПТК. Результатом работ по этапу является: - утвержденное ТЗ №1 на Изделие, содержащее перечень функциональных, технических требований. | шт | 1 | 30 000,00 | 30 000,00 | 6 600,00 | 7
2.101.3 | Разработка ТЗ №2 на адаптацию ПТК. Постаматный вендинговый аппарата, модель «Knowhy» G80/master | ТЗ на определения реестра технических и организационных мероприятий нацеленных на адаптацию ПТК для управления Изделием. Результатом работ по этапу является: - утвержденное ТЗ №2, на адаптацию ПТК. | шт | 1 | 30 000,00 | 30 000,00 | 6 600,00 | 7
2.102.1 | Адаптация, комплектование и сборка ПТК в соответствии с ТЗ №2. Постаматный вендинговый аппарата, модель «Knowhy» G80/master | Комплектование и сборка ПТК, адаптированного для управления Изделием. Результатом работ по этапу является: - полнофункциональный укомплектованный ПТК для управления изделием. | шт | 1 | 2 400 000,00 | 2 400 000,00 | 528 000,00 | 80
2.103.1 | Комплексное тестирование аппарата на базе новой системы управления. Постаматный вендинговый аппарата, модель «Knowhy» G80/master | Комплексные испытания одного аппарата с обновленным набором сенсоров, актуаторов и новой системы управления. Результатом работ по этапу является: - протокол комплексных испытаний; - откорректированное на основе тестов прикладное ПО всех уровней, прошедшее проверку реализованной функциональности; - акт готовности изделия к эксплуатации. | шт | 1 | 350 000,00 | 350 000,00 | 77 000,00 | 14

ИТОГО СТОИМОСТЬ БЕЗ НДС: | 2 960 000,00 (Два миллиона девятьсот шестьдесят тысяч рублей 00 копеек)
НДС (22%): | 651 200,00 (Шестьсот пятьдесят одна тысяча двести рублей 00 копеек)
ИТОГО СТОИМОСТЬ С НДС: | 3 611 200,00 (Три миллиона шестьсот одиннадцать тысяч двести рублей 00 копеек)

УСЛОВИЯ:

У.1

Данная Спецификация является калькуляцией работ по Заказу №2 от 16.10.2026. Предложение определяет перечень работ по проекту:
Реверс-инжиниринг постаматного вендингового аппарата Knowhy G80/master. Адаптация ПТК "HorizonVM Post M80 rev1".

Для выполнения работ необходимы материальные ресурсы, которые Заказчик передает Исполнителю, в установленные графиком поставки материальных ресурсов (п. У.4). Передача материальных ресурсов отражается составлением формы М15.

Перечень работ представленный в Спецификации, не предусматривает:
- разработку конструкторской документации (КД);
- разработку эксплуатационной документации (ИД);
- изготовление металлоконструкций и/или иных конструкций, определенных в разрабатываемой конструкторской документации.

Данные работы планируются отдельным Заказом.
У.2 | В результате выполнения работ по данной Спецификации Исполнитель создает РИД: - прикладное программное обеспечение уровня "User space".

У.3

Условия оплаты:

1. первый авансовый платеж в размере 1 964 200 руб. (один миллион девятьсот шестьдесят четыре тысячи двести рублей 00 копеек), в т.ч. НДС (22%) 354 200 руб. (триста пятьдесят четыре тысячи двести рублей ноль копеек), перечисляется на счет Исполнителя в течение 3 (трех) рабочих дней после подписания Спецификации и выписки счета. Пропорция авансового платежа составляет 55% от общей стоимости работ;
2. второй авансовый платеж в размере 1 220 000 руб. (один миллион двести двадцать тысяч) рублей 00 копеек, включая НДС (22%) в сумме 220 000 руб. (двести двадцать тысяч) рублей 00 копеек ), перечисляется на счет Исполнителя в течение 30 (тридцати) календарных дней после подписания Спецификации и выписки счета. Пропорция авансового платежа составляет 33% от общей стоимости работ.
3. постоплата в размере 427 000 руб. (четыреста двадцать семь тысяч рублей 00 копеек), в т.ч. НДС (22%) 77 000 руб. (семьдесят семь тысяч рублей ноль копеек) перечисляется на счет Исполнителя по факту выполнения работ, подписания акта выполненных работ и выписки счета. Пропорция платежа составляет 12% от общей стоимости работ.

Указанные в У.3 величины процентов являются приблизительными и служат для целей финансового планирования, при расчетах необходимо опираться на стоимости работ в рублях.

У.4

Заказчик обязуется доставить требуемые материальные ресурсы на производственную площадку Исполнителя в соответствии с условиями:

1. не ранее 21 (двадцати одного) календарного дня с даты зачисления на р/с первого авансового платежа;
2. не позднее 45 (сорока пяти) календарных дней с даты зачисления на р/с первого авансового платежа.

Для выполнения работ Заказчик передает Исполнителю один экземпляр вендингового шкафа "Knowhy G80", с полным комплектом работоспособных актуаторов и сенсоров, на все время проведения работ.
Заказчик обязуется самостоятельно доставить указанные материальные ресурсы на производственную площадку Исполнителя. По окончанию работ Заказчик своими силами забирает переданные ресурсы с площадки Исполнителя, если стороны не договорятся об ином.

Данные условия являются эквивалентом графика поставки материальных ресурсов, стороны по обоюдному согласию могут их изменить.
У.5 | Цены на работы являются фиксированными и могут быть изменены только по соглашению Сторон.
У.6 | В случае если стороны решат досрочно прекратить выполнение работ, Исполнитель передает все наработки выполненные к моменту принятия решения, по которым Заказчиком произведен авансовый платеж. В случае полного выполнения работ Исполнителем по любому из этапов – Заказчик осуществляет финальный платеж. Заказчик обязан принять выполненные работы, возврат авансовых платежей Заказчику не производится, никакие проценты за пользование Исполнителем денежными средствами, в соответствии со ст. 317.1., ст. 395 ГК РФ и иные проценты не начисляются.
У.7 | Общий срок оказания услуг по всем этапам составляет 140 календарных дней с даты зачисления первого авансового платежа на р/с, при соблюдении графика платежей в соответствии с п. У.3 данной Спецификации, а также передачи Исполнителю материальных ресурсов в соответствии с п. У.4.
У.8 | Исполнитель письменно уведомляет Заказчика о завершении каждого этапа, предусмотренного настоящей Спецификацией, и по требованию Заказчика обязуется предоставить промежуточные результаты работ/услуг для проверки в течение 3 (трех) рабочих дней с даты получения запроса.
У.9 | Гарантийный срок на результат работ/услуг составляет 12 (двенадцать) месяцев с даты подписания Акта сдачи-приемки.
У.10 | Адрес производственной площадки Исполнителя: 443029 г. Самара, 6-я Просека, д. 144
У.11 | Условия, представленные в Спецификации, действуют до 22 октября 2026 г, в случае не акцептования Спецификации, необходимо запросить обновленную версию Спецификации.
У.12 | Представители Сторон:
| От Заказчика: Сидоров Семен Евгеньевич, Директор, Тел.: +7 963 856-21-31, e-mail: ss@tm96.ru | От Исполнителя: Кукушкин Иван Николаевич, Генеральный директор, Тел.: +7 917 119-05-01, e-mail: ivan.kukushkin@mas-tech.ru

ЗАКАЗЧИК: ООО «ТМ Технология» Фактический адрес: 620078, г. Екатеринбург, ул. Педагогическая, 8А, офис 36 Тел.: +7 962 312-22-68, Юридический адрес: 620078, г. Екатеринбург, ул. Педагогическая, 8А, офис 36 ОГРН 1269600008336 ИНН 6670533502 КПП 667001001 Банк получателя: ФИЛИАЛ "ЕКАТЕРИНБУРГСКИЙ" АО "АЛЬФА-БАНК" г. Екатеринбург Р/с 40702810438060004958 К/С 30101810100000000964 БИК 046577964 | | ИСПОЛНИТЕЛЬ: ООО «Горизонт» Фактический адрес: 443050, г. Самара, ул. Бугурусланская, д.81 Тел. +7 917 119-05-01 Юридический адрес: 443050, г. Самара, ул. Бугурусланская, д.81 ОГРН 1096312002060 ИНН 6312217507 КПП 631201001 Банк получателя: ПАО «СБЕРБАНК» Р/с 40702810854400007922 К/с 30101810200000000607 БИК 043601607 Электронная почта: info@mas-tech.ru
Директор _____________________С. Е. Сидоров | | Генеральный директор ______________________И.Н. Кукушкин

_____________________С.Е. Сидоров ______________________И.Н. Кукушкин Страница 2 из 2
