Konkery/Project-8_2026-N2-HORIZON/01__Документация/Переписка/02__Исходящие/00__draft/Письмо-ТМ Технология - О старте работ - № 8_2026-N2-Горизонт-M1.docx

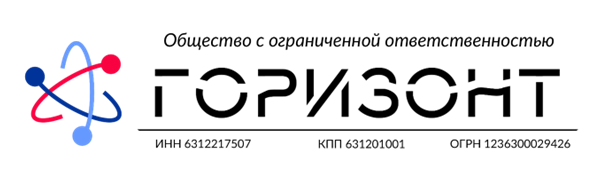
[picture p1: figure]

Исх. № 8/2026-N2-Горизонт-M1 от 26.10.2026 | Директору ООО «ТМ Технология» Сидорову Семену Евгеньевичу
О старте работ

УВАЖАЕМЫЙ СЕМЕН ЕВГЕНЬЕВИЧ !

Подтверждаем следующее:

1. 21 октября 2026 г. на расчётный счёт Исполнителя поступил авансовый платёж в размере 1 964 200,00 руб. (в том числе НДС 22% - 354 200,00 руб.) по счёту № 2 от 20.10.2026 - в соответствии с п. У.3.1 Спецификации № 2.
2. Исполнитель приступил к выполнению работ по Заказу № 2 - реверс-инжиниринг постаматного вендингового аппарата Knowhy G80/master с адаптацией ПТК "Horizon VM Post M80 rev.01" .

С уважением, генеральный директор ООО "Горизонт" | __________________ И.Н. Кукушкин
Исп. Н.В. Кукушкина natalya.kukushkina@mas-tech.ru
