Konkery/Project-8_2026-N2-HORIZON/02__Спецификации/01__Заказы/Заказ_N2-08_2026 19_10_2026 sign.pdf

Страница 1 из 2

### Приложение №1

### к договору 8/2026

### от «01» сентября 2026

### ЗАКАЗ N2-8/2026

### от «19» октября 2026

### Предмет заказа: Разработка конструкторской документации (КД) для размещения ПТК

### "Horizon VM Hybrid M96/50" в металлическом шкафу "Knowhy N96" (в соответствии со

Спецификацией № 1 от 20.10.2026).

### На основании Рамочного договора подряда № 8/2026, просим Вас выполнить следующий

### комплекс работ:

№ п/п | НАИМЕНОВАНИЕ | КОЛ-ВО | ПРИМЕЧАНИЕ
1 | Инженерный анализ существующей конструкции изделия (изучение характеристик, получение параметров, формирование внутреннего технического отчета). | 1
2 | Разработка ТЗ №1 на изделие в целом (определение функциональных, технических требований и списка корректируемых разделов). | 1
3 | Разработка ТЗ №2 на адаптацию ПТК (определение реестра технических и организационных мероприятий). | 1
4 | Адаптация, комплектование и сборка ПТК в соответствии с ТЗ №2. | 1
5 | Комплексное тестирование аппарата на базе новой системы управления (с выдачей протокола испытаний и акта готовности). | 1

### 2. Требования к предоставлению документов

### Просим Вас в ответ на настоящий Заказ:

1. Подтвердить принятие работ к исполнению.

### 2. Подписать прилагаемую Спецификацию № 2

### 3. Выставить счет на оплату первого авансового платежа в соответствии с условиями

Спецификации.

### Ожидаемый результат работ: Комплект КД, Полнофункциональный укомплектованный ПТК

для управления изделием, протокол комплексных испытаний.

ДОКУМЕНТ ПОДПИСАН ЭЛЕКТРОННОЙ ПОДПИСЬЮ | Идентификатор: 39ec5caa-9420-4692-8964-7050245f4654
ОТПРАВЛЕНО | ООО "ТМ ТЕХНОЛОГИЯ", СИДОРОВ СЕМЕН ЕВГЕНЬЕВИЧ,
ДИРЕКТОР

21.10.26 14:34 (MSK) Сертификат 02414778001DB475A14F0934C1D7793FBA

Оператор ЭДО ООО "Компания "Тензор"

Страница 2 из 2

ЗАКАЗЧИК:
ООО «ТМ ТЕХНОЛОГИЯ»

Фактический адрес: 620078, г. Екатеринбург, ул. Педагогическая, 8А, офис 36
Тел.: +7 905 801,
Юридический адрес: 620078, г. Екатеринбург, ул. Педагогическая, 8А, офис 36

ОГРН 1269600008336
ИНН 6670533502
КПП 667001001
Банк получателя: ФИЛИАЛ
"ЕКАТЕРИНБУРГСКИЙ" АО "АЛЬФА-БАНК" г. Екатеринбург

Р/с 40702810438060004958
К/С 30101810100000000964
БИК 046577964

Электронная почта: sidorovsemoyn@yandex.ru

Директор

_____________________С.Е. Сидоров

ДОКУМЕНТ ПОДПИСАН ЭЛЕКТРОННОЙ ПОДПИСЬЮ | Идентификатор: 39ec5caa-9420-4692-8964-7050245f4654
ОТПРАВЛЕНО | ООО "ТМ ТЕХНОЛОГИЯ", СИДОРОВ СЕМЕН ЕВГЕНЬЕВИЧ,
ДИРЕКТОР

21.10.26 14:34 (MSK) Сертификат 02414778001DB475A14F0934C1D7793FBA

Оператор ЭДО ООО "Компания "Тензор"
