Konkery/Project-8_2026-N2-HORIZON/05__Счета/02__Исходящие/Счет-ТМ Технология - №2 от 20.10.2026 #8_2026-N2-Горизонт.pdf

CueT Ha onnatyNe 2oT 20 oKTA6pA 2026 r.

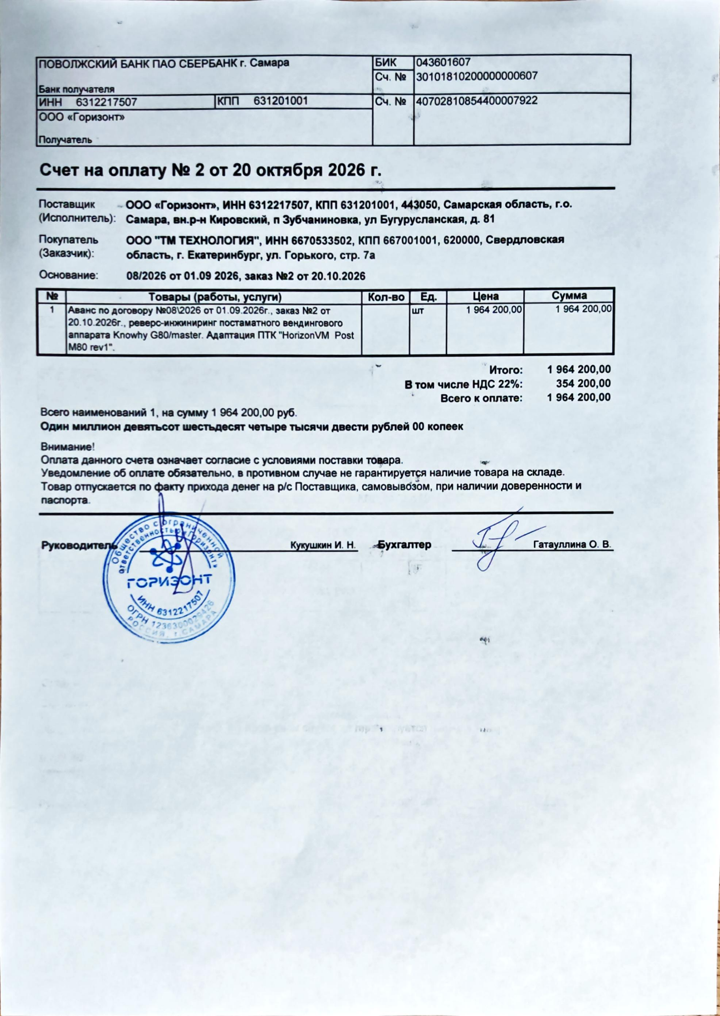
[picture p2: page 1]

nOBODKCKMM BAHK IAO CBEPBAHK | Camapa | BMK | 043601607
C4. Ne 30101810200000000607 5aHK nonyatenA
MHH 6312217507 | KN 631201001 | C4. Ne 40702810854400007922

|O00«fopw3OHT»>

Nonyarenb

NocraBuMK | O00 «rop3ONTI, MHH 6312217507,KN631201001,443050,CaMapckas o6nacTb, r.o.
(McnonHTenb): Camapa, BH.p-H | KupoBcKMñ, n 3y6vaHMHOBKa, yn 5yrypycnaHCKaR,A. 81
orynarenb | 000"TMTEXHOnorua",MHH 6670533502, KNN667001001,620000,CeePAnOBCKas
(3akasuK): | o6nacTb, r. ExarepMH6ypr, yn. opbKoro, cTp. 7a
OCHOBaHHe: | 08/2026oT 01.09 2026,sakas Ne2 oT 20.10.2026
Ne | TOBapb(pa6oTbl,ycnyrw) | Kon-Bo | Eg. | eHa | CyMMa
1 | ABaHc no AoroBopy | Ne082026 | oT O1.09.2026r., sakas N&2 oT | uT | 964 200,00 | 1 964 200,00
|20.10.2026r., pesepo-MHNOHHMPWHr | nocTaMaTHoro | BeHAMHOBOrO
annapara | Knowhy G80/master. Aganrauna | iTK "HorizonVM | Post
| M80 rev1".
| | | | | MToro: | 1964 200,00
BTOM YMCne HAC 22%: | 354 200,00
| | | | | Bcero K onnaTe: | 1 964 200,00
Boero HaMMeHOBaHMA 1, Ha cyMMy 1 964 200,00 py6.
OAMH MMOHAeBATbCOT WeCThAecAT YETbipe TbiCAYMABecTM py6neñ 00 Koneek

BHMMaHwe!
Onnata AaHHOro Herao3HavaeT cornacnecycnoBuAMM nocTaBKM | TOBapa.
yeenoMeHwe o6 onnare o6R3aTenbHO.B npoTMBHOM CnyNaeHe rapaHTVpyerca | HanMMe ToBapa Ha CKnage.
ToBap onmyaraercR | no @army npvoxoga | AeHer Ha plc | ocTaBuMKa | ,caMoBblB3oM, npM HanMMM | AOBepeHOCTM M

nacnopTa.

| | brp
fT
yKOBOATen. | KykyuKMH | M. H. | Eyxrarep | TaraynnmHa | B.

# roPHT

63122

PO 123630 .CA
