Konkery/Project-8_2026-N2-HORIZON/03__Проект/77__Контрагенты/02__ТМ Технология/03__Out/02__Заказ-доработка_металлоконструкции_Knohwy/Заказ-№ 3 - Доработка металлоконструкции - МАС #27_2025-n3-mas.pdf

Приложение №1
к договору 27/2025
от «13» ноября 2025

ЗАКАЗ № 3
«15» июня 2026

Заказ определяет перечень работ по проекту проведения конструкторских работ с экземпляром вендингового аппарата производства «Knowhy» модель N96 Main Box (далее Изделие).
Работы нацелены на адаптацию существующей конструкции Изделия с разработанным в рамках договора "27/2025" / Заказ №1 Программно-Технического Комплекса - ПТК «MAS-n1701-F1757N001-VMhyb».
На время проведения работ Исполнителю будет передан, на давальческой основе, 1 (один) экземпляр Изделия, на базе которого ранее велись работы по созданию ПТК. Изделие будет доставлено на производственную площадку Исполнителя силами и за счет Заказчика. По окончанию работ Заказчик своими силами и за свой счет переместит модернизированное Изделие на свой склад, если Стороны не договорятся об ином.
По окончанию работ Исполнитель передает Заказчику разработанную конструкторскую документацию, полученную в ходе реализации проекта, а также модернизированное Изделие. В ответ на данный Заказ просим направить Спецификацию с указанием следующей информации:
- состав работ;
- сроки проведения работ;
- стоимость работ.
№ | НАИМЕНОВАНИЕ РАБОТ | КОЛ-ВО | СОСТАВ РАБОТ
1 | Конструкторские и инжиниринговые работы с вендинговым аппаратом «Knowhy» модель N96 Main Box | 1 | конструкторский блок: - определение перечня элементов Изделия, требующих доработки; - определение объема работ в соответствии с разрабатываемым перечнем элементов; - определение приоритетов этапов и их группировку по приоритету. интеграция: - адаптация ПТК к модернизированной конструкции Изделия; изготовление, монтаж: - изготовление разработанных узлов и элементов; - монтаж разработанных элементов в Изделие; - монтаж адаптированного ПТК в Изделие; тесты: - тестирование Изделия в собранном виде.

### ЗАКАЗЧИК: ООО «Точные машины»

### Директор

### _______________ Е.А. Приходько
