Konkery/Project-8_2026-N2-HORIZON/03__Проект/77__Контрагенты/01__Конструкторы/03__Out/10. Датчик температуры и влажности/Документы/DVT_05N.K.pdf

# Датчики влажности и температуры

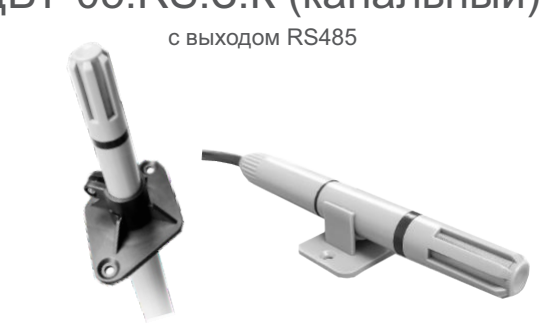
[picture p3: figure]
с выходом RS485

ПАСПОРТ И ИНСТРУКЦИЯ
ПО ЭКСПЛУАТАЦИИ

ДВТ-05.RS.З.Н (настенный),

### Назначение прибора

Датчики влажности и температуры ДВТ-05.RS.З.Н и ДВТ-05.RS.З.К (далее - приборы) предназначены для контроля температуры и отн. влажности воздуха, и неагрессивных газов в различных областях промышленности, сельском и коммунальном хозяйстве.
Приборы применяются в качестве ведомых устройств (Slave) в промышленных сетях RS-485 с протоколом Modbus-RTU.
В зависимости от способа крепления приборы делятся на 2 типа: -ДВТ-05.RS.З.Н - настенный;
-ДВТ-05.RS.З.К - канальный.

### Комплектность

ДВТ-05.RS.З.Н или ДВТ-05.RS.З.К - 1 шт; паспорт и инструкция по эксплуатации - 1 шт; индивидуальная картонная упаковка - 1 шт; крепление - 1 шт;
дюбель-шуруп - 2 шт

### Условия эксплуатации

Прибор предназначен для эксплуатации при температуре окружающей среды от минус 40 до плюс 85 °С, отн. влажности воздуха не более 95% и атмосферном давлении от 630 до 800 мм рт.ст. без конденсации влаги.

### Технические характеристики

Абсолютная погрешность измерения:
- температура, °С
- относительная влажность, %

± 0,5

Диапазоны измерения:
- температура, °С
- относительная влажность, %

от -40 до +85
от 0 до 95

± 3,0

Напряжение питания прибора постоянным током, В: | 5...24

Дополнительная погрешность измерения относительной
влажности

± 10% от основной
абсолютной погрешности
на каждые 10 °С изменения
температуры окружающей среды
Протокол передачи данных | Modbus RTU

4800, 9600, 19200

Параметры интерфейса:

Скорость обмена данными, бит/с
(задаётся при настройке)

32

Габаритные размеры, мм | 16х140
Масса прибора, не более, кг | 0,2
Средняя наработка на отказ, не менее, ч | 50000
Средний срок службы, лет | 5
Степень защиты от пыли и влаги | IP54

Изготовитель ООО НПК «РЭЛСИБ» 630082 Россия, г. Новосибирск, ул. Дачная, 60, корп. 1, пом. 62, тел. +7 (383) 383-02-94, E-mail: tech@relsib.com

Максимальное количество приборов в цепи

Разрешающая способность | 0,1
Максимальное расстояние передачи данных, м | 1000

Постоянная времени измерения при скорости воздуха
не менее 1 м/с, с
- температура | 25
- относительная влажность | 8

### Установка и подключение

1. Выполните последовательность действий, указанных на рисунке 1, чтобы открыть отсек с DIPпереключателями.
Шаг 1 | Шаг 2 | DIP переключатели
2. С помощью DIP переключателей установите адрес прибора (пример на Рис. 2).
DIP переключатель имеет 8 позиций, соответствующих числам: 128, 64, 32, 16, 8, 4, 2, 1. При сложении данных чисел (включение соответствующего DIP переключателя) образуется адрес прибора.

# ДВТ-05.RS.З.К (канальный)

Период измерений, с | 30

### Гарантии изготовителя

Предприятие - изготовитель гарантирует соответствие датчика влажности и температуры ДВТ-05.RS.З.____ требованиям настоящего паспорта и инструкции по эксплуатации при соблюдении потребителем правил транспортирования, эксплуатации и хранения приборов.
Гарантийный срок эксплуатации прибора - 24 месяца.

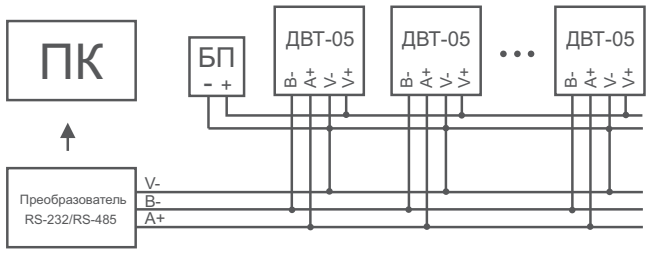
[picture p4: figure]
Преобразователь; ДВТ-05 В⁻ А⁺

Приборы могут транспортироваться только в транспортной таре и потребительской упаковке изготовителя всеми видами транспортных средств при температуре от минус 40 до плюс 45 °С.
При транспортировке необходимо обеспечить защиту от резких ударов, падений и воздействия климатических факторов.
Приборы следует хранить в отапливаемом помещении с естественной вентиляцией при температуре от 0 до плюс 45 °С и отн. влажности до 95% при температуре 25 °С без конденсации влаги.

### Транспортировка и хранение

### Меры безопасности

Защищайте приборы от попадания на него влаги, конденсата или различных загрязнений.
Устанавливайте приборы в месте, недоступном для маленьких детей. Устанавливайте приборы вдали от прямых солнечных лучей и нагревательных приборов.
1. Неверен адрес устройства или имеются устройства с повторяющимися адресами (все заводские настройки по умолчанию равны 1).
2. Установленные параметры протокола Modbus неверны.
3. Шина RS485 отсоединена, или провода Aи Bперепутаны.
4. При большом количестве приборов в сети или длинной линии связи добавьте усилитель сигнала RS485 и согласующийся резистор 120 Ом.
5. Драйвер USB - RS485 не установлен или поврежден.

### Возможные неисправности

### Сведения о приёмке

Датчик температуры и относительной влажности ДВТ-05.RS.З.____ зав. номер __________ изготовлен и принят в соответствии с обязательными требованиями государственных (национальных) стандартов, действующей технической документацией и признан годным для эксплуатации

______________ | __________________ | _____________
(личная подпись) | (расшифровка подписи) | (число, месяц, год)

М.П.

Контролёр ОТК

Адреса регистров

Адрес
регистра
Значение | Обозначе- ние
Чтение/
запись

0

1 | Влажность Температура

Адрес
устройства

Скорость
передачи
данных

Только чтение

### Параметры протокола Modbus

Параметр

Параметр

4800, 9600,
19200

Рис. 4

4

5

6

7

Устанавливается
с помощью
DIP переключателей

Версия ПО

Версия прошивки

Только чтение

Чтение и запись

Только чтение

Только чтение

Только чтение

Если в сети более одного прибора, то в начале и конце линии необходимо установить согласующее сопротивление 120 Ом. Длина линии связи не должна превышать 1000 метров. Количество приборов в линии не должно быть более 32.
Все приборы должны иметь разные адреса.

!

### ПРИМЕЧАНИЕ

Подключение нескольких приборов к сети RS485 осуществляется в соответствии со схемой (Рис. 4)

Команда

03

03

03

03

03

03

Рис.2

Вкл

Выкл

1 | 2 | 3 | 4 | 5 | 6 | 7 | 8
128 64 | 32 | 16 | 8 | 4 | 2 | 1

Пример
Адрес
устройства = 3
3. Подключите прибор к ПК с помощью преобразователя интерфейсов, например RS485/USB в соответствии с Рисунком 3.
4. Установите на ПК программное обеспечение Modbus Pool (не поставляется с прибором) и установите скорость передачи данных прибора 4800, 9600 или 19200 бит/с (по умолчанию 9600).

Значения протокола Modbus по умолчанию

Код

Бит данных

Бит чётности

Стоповый бит

Проверка
ошибок CRC

Скорость
передачи,
бит/с

8-бит

8

отсутствует

1

4800, 9600, 19200
(по умолчанию 9600)

Рис.3

V+

V-

A

Зелёный | B

Жёлтый

Чёрный

Красный
