Konkery/Project-8_2026-N2-HORIZON/03__Проект/77__Контрагенты/01__Конструкторы/03__Out/3. Аккумуляторная батарея/Документы/TI_DTM_1205_RU.pdf

# DTM 1205 12 В | 5 АЧ

## Сферы применения

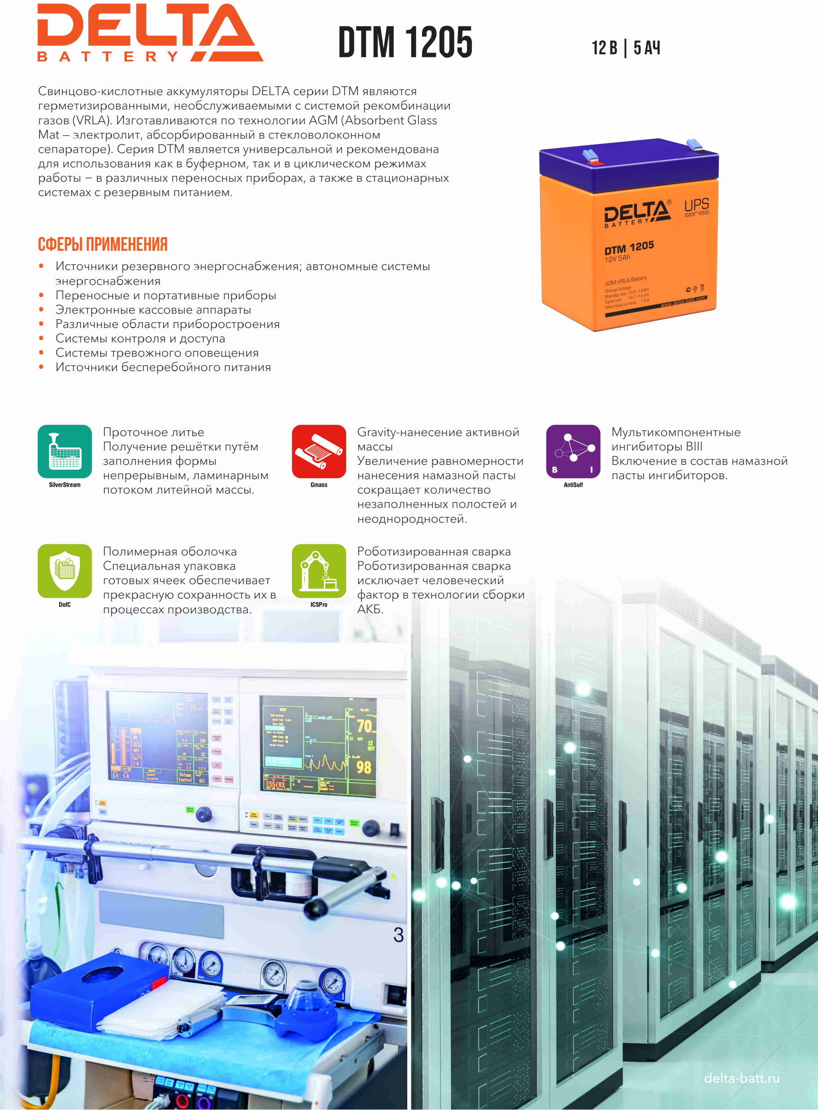
[picture p28: page 1]

delta-batt.ru

Свинцово-кислотные аккумуляторы DELTA серии DTM являются герметизированными, необслуживаемыми с системой рекомбинации газов (VRLA). Изготавливаются по технологии AGM (Absorbent Glass Mat — электролит, абсорбированный в стекловолоконном сепараторе). Серия DTM является универсальной и рекомендована для использования как в буферном, так и в циклическом режимах работы − в различных переносных приборах, а также в стационарных системах с резервным питанием.

Проточное литье
Получение решётки путём
заполнения формы
непрерывным, ламинарным
потоком литейной массы.

Gravity-нанесение активной массы
Увеличение равномерности
нанесения намазной пасты
сокращает количество
незаполненных полостей и
неоднородностей.

Мультикомпонентные
ингибиторы BIII
Включение в состав намазной пасты ингибиторов.

Полимерная оболочка
Специальная упаковка
готовых ячеек обеспечивает прекрасную сохранность их в процессах производства.

Роботизированная сварка
Роботизированная сварка
исключает человеческий
фактор в технологии сборки АКБ.

Источники резервного энергоснабжения; автономные системы энергоснабжения

•

- Переносные и портативные приборы
- Электронные кассовые аппараты
- Различные области приборостроения
- Системы контроля и доступа
- Системы тревожного оповещения
- Источники бесперебойного питания

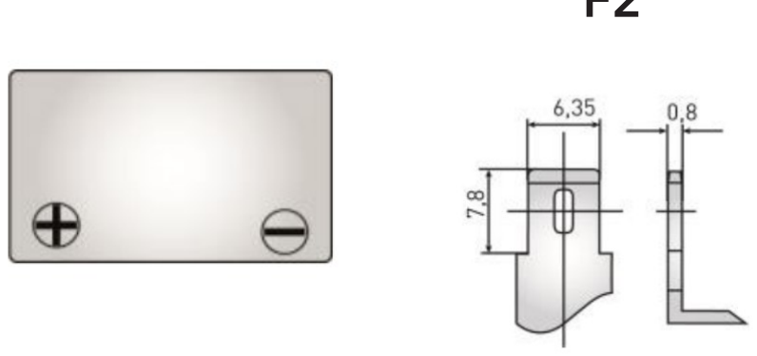
[picture p29: figure]
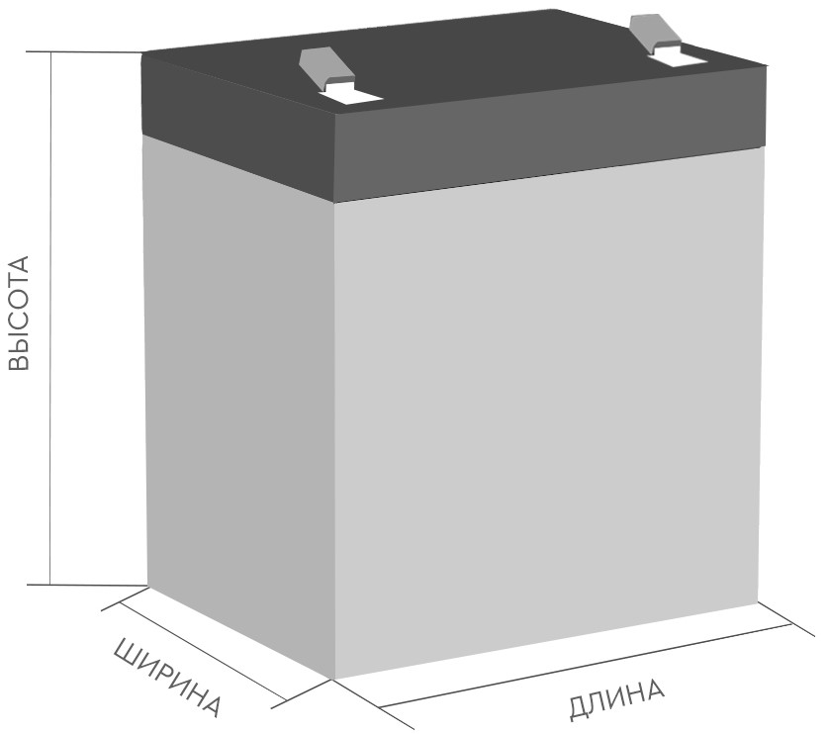
[picture p30: figure]

Артикул: 4614010050006

DELTA — промышленные аккумуляторные батареи, представленные на российском рынке с 2001 года. DELTA предлагает различные серии аккумуляторных батарей, оптимизированных в зависимости от назначения: от систем телекоммуникаций и связи до источников бесперебойного питания и мототехники.
delta-batt.ru

# DTM 1205 12 B | 5 АЧ

## Преимущества

## Зарядные параметры

1.5A

30мВ/°С

20мВ/°С

## Разряд постоянным током, А (при 25°С)

В/эл-т | 10 мин | 15 мин | 30 мин | 1 ч | 3 ч | 5 ч | 10 ч | 20 ч
1.60 | 13.8 | 12.7 | 6.50 | 3.58 | 1.47 | 0.96 | 0.51 | 0.26
1.65 | 13.1 | 12.0 | 6.31 | 3.45 | 1.43 | 0.95 | 0.50 | 0.26
1.70 | 12.4 | 11.5 | 5.97 | 3.32 | 1.38 | 0.93 | 0.49 | 0.26
1.75 | 11.7 | 10.9 | 5.68 | 3.18 | 1.32 | 0.90 | 0.48 | 0.25
1.80 | 11.0 | 10.3 | 5.39 | 3.03 | 1.27 | 0.86 | 0.47 | 0.25

## Разряд постоянной мощностью, Вт/эл-т(при 25°С)

В/эл-т | 10 мин | 15 мин | 30 мин | 1 ч | 3 ч | 5 ч | 10 ч | 20 ч
1.60 | 25.6 | 22.8 | 12.2 | 6.94 | 2.79 | 1.90 | 0.99 | 0.50
1.65 | 24.2 | 21.8 | 11.5 | 6.73 | 2.72 | 1.86 | 0.98 | 0.49
1.70 | 22.7 | 20.6 | 10.9 | 6.37 | 2.62 | 1.84 | 0.96 | 0.48
1.75 | 21.3 | 19.4 | 10.3 | 6.04 | 2.57 | 1.78 | 0.95 | 0.48
1.80 | 19.7 | 18.0 | 9.6 | 5.70 | 2.45 | 1.70 | 0.93 | 0.48

Примечание: приведенные выше данные по характеристикам являются средними значениями, полученными в результате проведения 3-х контрольно-тренировочных циклов, и не являются номинальными по умолчанию.

## Рабочий диапазон температур

-20...60°C
-10...60°C
-20...60°C

## Габариты (±2 мм)

90
70
101
107
1.8

## Технические характеристики

12В
6
8 лет

270 циклов
460 циклов
1250 циклов

5.03 Ач
4.79 Ач
4.48 Ач
3%/мес. при 25°С
34мОм
75 А (5 с)
Корпус B | Тип клемм F2

## Конструкция батареи

Компонент | Полож. пластина | Отриц. пластина | Корпус | Крышка | Клапан | Клеммы | Сепаратор | Электролит
Материал | Диоксид свинца | Свинец | ABS | ABS | Каучук | Медь | Стекловолокно | Серная кислота

Продукция постоянно совершенствуется, поэтому фирма-изготовитель оставляет за собой право вносить изменения без предварительного уведомления. Перед началом использования внимательно ознакомьтесь с инструкцией по эксплуатации.

Технология AGM позволяет
рекомбинировать до 99%выделяемого газа

•

- Нет ограничений на воздушные перевозки
- Соответствие требованиям UL; IEC; Гост Р Легированные кальцием пластины обеспечивают низкий саморазряд, высокую конструктивную плотность решетки

•

Необслуживаемые. Не требует долива воды

•

- Высокая плотность энергии
Корпус аккумулятора выполнен из пластика ABS, не поддерживающего горение

•

Макс. зарядный ток |
Циклический режим (2.45÷2.47 В/эл)
Температурная компенсация |
Буферный режим (2.27÷2.3 В/эл)
Температурная компенсация |
Разряд |
Заряд |
Хранение |
Длина, мм |
Ширина, мм |
Высота, мм |
Полная высота, мм |
Вес (±3%),кг |
Номинальное напряжение |
Число элементов |
Срок службы |
Срок службы в циклическом режиме
100% DOD |
50% DOD |
30% DOD |
Номинальная емкость (25 °С)
20 часовой разряд (0.25 А; 1.75 В/эл) |
10 часовой разряд (0.48 А; 1.75 В/эл) |
5 часовой разряд (0.90 А; 1.75 В/эл) |
Саморазряд |
Внутреннее сопротивление полностью заряженной батареи (25°С) |
Максимальный разрядный ток (25°С) |
