Konkery/Project-8_2026-N2-HORIZON/02__Спецификации/03__ТКП/02__Участники/20__Спецификация-МАС - work spec rev.01 v01 #8_2026-n2-горизонт.xlsx

Sheet: SpecificationWork
№ п/п | № ИСХ | № КОМПЛЕКТА | № ПОРЯДКОВЫЙ В КОМПЛЕКТЕ | № ПОЛНЫЙ | ОПИСАНИЕ КОМПЛЕКТА | НАИМЕНОВАНИЕ | ОПИСАНИЕ/ХАРАКТЕРИСТИКИ | On-Off | ПРИЗНАК ПОСТ ОБРАБОТКИ | БРЕНД | ПОСТАВЩИК | АРТИКУЛ ПОСТАВЩИК | АРТИКУЛ МАС | ЕД ИЗМ | КОЛИЧЕСТВО В КОМПЛЕКТЕ | КОМПЛЕКТОВ В ПОСТАВКЕ | КОЛИЧЕСТВО ИТОГО | КОЛИЧЕСТВО У ПОСТАВ-КА | ЦЕНА ЗА ЕД. $ЗАКУП | СЕБЕСТОИМОСТЬ $ЗАКУП | КОЭФФИЦИЕНТ НАЦЕНКИ | ЦЕНА ЗА ЕД. $РЕАЛИЗАЦИЯ | СТОИМОСТЬ $РЕАЛИЗАЦИЯ | ЦЕНА ЗА ЕД. $ИТОГ | СТОИМОСТЬ $ИТОГ | СРОК ПОСТАВКИ $ИТОГ | ТРЕБОВАНИЯ ИСХОДНЫЕ | ПРИМЕЧАНИЕ | ССЫЛКА | ИЗОБРАЖЕНИЕ ТМЦ
1 |  | 1 | 1 | 1.1 | Инжиниринг проектный - КД | Инженерный анализ существующей конструкции постаматного вендингового аппарата | Изучение конструкционных, функциональных характеристик существующего аппарата. Получение списка характеристик отличающих его от модели "Knowhy" модель N96 Main Box. Результатом работ по этапу является: - внутренний технический отчет о выявленных качественных и количественных отличиях от модели "Knowhy" модель N96 Main Box в части организации управления постаматной секции. | on | none | МАС | МАС | none | none | этап | 1 | 1 | 1 | 1 | 150000.00 | 150000.00 | 1.07 | 160500.00 | 160500.00 | 160500.00 | 160500.00 | 13
2 |  | 1 | 2 | 1.2 | Инжиниринг предпроектный - КД | Разработка ТЗ №1 на изделие в целом | Определение функциональных, технических требований к изделию в целом. Проработка списка требуемых корректируемых разделов требуемых для адаптации ПТК. Результатом работ по этапу является: - утвержденное ТЗ №1 на Изделие, содержащее перечень функциональных, технических требований. | on | none | МАС | МАС | none | none | этап | 1 | 1 | 1 | 1 | 30000.00 | 30000.00 | 1.07 | 32100.00 | 32100.00 | 32100.00 | 32100.00 | 7
3 |  | 1 | 3 | 1.3 | Инжиниринг проектный - КД | Разработка ТЗ №2 на адаптацию ПТК к данной модели | ТЗ на определения реестра технических и организационных мероприятий нацеленных на адаптацию ранее разработанного (для модели "Knowhy" модель N96 Main Box) ПТК для управления Изделием. Результатом работ по этапу является: - утвержденное ТЗ №2, на адаптацию ПТК. | on | none | МАС | МАС | none | none | этап | 1 | 1 | 1 | 1 | 30000.00 | 30000.00 | 1.07 | 32100.00 | 32100.00 | 32100.00 | 32100.00 | 7
4 |  | 2 | 1 | 2.1 | Инжиниринг проектный - АСУ | Адаптация, комплектование и сборка ПТК в соответствии с ТЗ №2 | Комплектование и сборка ПТК, адаптированного для управления Изделием. Результатом работ по этапу является: - полнофункциональный укомплектованный ПТК для управления изделием. | on | none | МАС | МАС | none | none | этап | 1 | 1 | 1 | 1 | 1700000.00 | 1700000.00 | 1.07 | 1819000.00 | 1819000.00 | 1819000.00 | 1819000.00 | 60
5 |  | 3 | 1 | 3.1 | Инжиниринг постпроектный - КД | Комплексное тестирование аппарата на базе новой системы управления | Комплексные испытания одного аппарата с обновленным набором сенсоров, актуаторов и новой системы управления. Результатом работ по этапу является: - протокол комплексных испытаний; - откорректированное на основе тестов прикладное ПО всех уровней, прошедшее проверку реализованной функциональности; - акт готовности изделия к эксплуатации. | on | этап | МАС | МАС | none | none | этап | 1 | 1 | 1 | 1 | 350000.00 | 350000.00 | 1.07 | 374500.00 | 374500.00 | 374500.00 | 374500.00 | 13
Итог |  |  |  |  | 5 |  |  |  |  |  |  |  |  |  |  |  |  |  | 2260000.00 |  |  |  |  |  | 2418200.00 | 100 |  |  |  | 0

Sheet: TableShema
TABLE_NAME | СOLUMNS_NAME | СOLUMN_DESCRIPTIONS
TabSpecificationWork | № п/п
TabSpecificationWork | № ИСХ
TabSpecificationWork | № КОМПЛЕКТА
TabSpecificationWork | № ПОРЯДКОВЫЙ В КОМПЛЕКТЕ
TabSpecificationWork | № ПОЛНЫЙ
TabSpecificationWork | ОПИСАНИЕ КОМПЛЕКТА
TabSpecificationWork | НАИМЕНОВАНИЕ
TabSpecificationWork | ОПИСАНИЕ/ХАРАКТЕРИСТИКИ
TabSpecificationWork | On-Off
TabSpecificationWork | ПРИЗНАК ПОСТ ОБРАБОТКИ
TabSpecificationWork | БРЕНД
TabSpecificationWork | ПОСТАВЩИК
TabSpecificationWork | АРТИКУЛ ПОСТАВЩИК
TabSpecificationWork | АРТИКУЛ МАС
TabSpecificationWork | ЕД ИЗМ
TabSpecificationWork | КОЛИЧЕСТВО В КОМПЛЕКТЕ
TabSpecificationWork | КОМПЛЕКТОВ В ПОСТАВКЕ
TabSpecificationWork | КОЛИЧЕСТВО ИТОГО
TabSpecificationWork | КОЛИЧЕСТВО У ПОСТАВ-КА
TabSpecificationWork | ЦЕНА ЗА ЕД. $ЗАКУП
TabSpecificationWork | СЕБЕСТОИМОСТЬ $ЗАКУП
TabSpecificationWork | КОЭФФИЦИЕНТ НАЦЕНКИ
TabSpecificationWork | ЦЕНА ЗА ЕД. $РЕАЛИЗАЦИЯ
TabSpecificationWork | СТОИМОСТЬ $РЕАЛИЗАЦИЯ
TabSpecificationWork | ЦЕНА ЗА ЕД. $ИТОГ
TabSpecificationWork | СТОИМОСТЬ $ИТОГ
TabSpecificationWork | СРОК ПОСТАВКИ $ИТОГ
TabSpecificationWork | ТРЕБОВАНИЯ ИСХОДНЫЕ
TabSpecificationWork | ПРИМЕЧАНИЕ
TabSpecificationWork | ССЫЛКА
TabSpecificationWork | ИЗОБРАЖЕНИЕ ТМЦ

Sheet: ConfigJSON
IDnum | IDconfig | CONFIG_JSON | COMMENT
