Konkery/Project-8_2026-N2-HORIZON/05__Счета/02__Исходящие/05_Счет- Счет №2 от 19.10.2026 - Точные машины - #8_2026-n2-горизонт.xlsx

ПОВОЛЖСКИЙ БАНК ПАО СБЕРБАНК г. Самара |  |  |  |  |  |  |  | БИК |  |  | 043601607
 |  |  |  |  |  |  |  | Сч. № |  |  | 30101810200000000607
Банк получателя
ИНН |  | 6312217507 |  |  | КПП | 631201001 |  | Сч. № |  |  | 40702810854400007922
ООО «Горизонт»
Получатель
Счет на оплату № 2 от 20 октября 2026 г.
Поставщик (Исполнитель): |  |  | ООО «Горизонт», ИНН 6312217507, КПП 631201001, 443050, Самарская область, г.о. Самара, вн.р-н Кировский, п Зубчаниновка, ул Бугурусланская, д. 81
Покупатель (Заказчик): |  |  | ООО "ТМ ТЕХНОЛОГИЯ", ИНН 6670533502, КПП 667001001, 620000, Свердловская область, г. Екатеринбург, ул. Горького, стр. 7а
Основание: |  |  | 08/2026 от 01.09 2026, заказ №2 от 20.10.2026
№ | Товары (работы, услуги) |  |  |  |  |  | Кол-во |  |  | Ед. |  | Цена |  | Сумма
1 | Аванс по договору №08\2026 от 01.09.2026г., заказ №2 от 20.10.2026г., реверс-инжиниринг постаматного вендингового аппарата Knowhy G80/master. Адаптация ПТК "HorizonVM Post M80 rev1". |  |  |  |  |  |  |  |  | шт |  | 1964200.00 |  | 1964200.00
 |  |  |  |  |  |  |  |  |  |  |  |  |  | Итого: | 1964200.00
 |  |  |  |  |  |  |  |  |  |  |  |  |  | В том числе НДС 22%: | 354200.00
 |  |  |  |  |  |  |  |  |  |  |  |  |  | Всего к оплате: | 1964200.00
Всего наименований 1, на сумму 1 964 200,00 руб.
Один миллион девятьсот шестьдесят четыре тысячи двести рублей 00 копеек
Внимание!
Оплата данного счета означает согласие с условиями поставки товара.
Уведомление об оплате обязательно, в противном случае не гарантируется наличие товара на складе.
Товар отпускается по факту прихода денег на р/с Поставщика, самовывозом, при наличии доверенности и паспорта.
Руководитель |  |  |  | Кукушкин И. Н. |  |  |  |  | Бухгалтер |  |  |  | Гатауллина О. В.
