Konkery/Project-8_2026-N2-HORIZON/02__Спецификации/02__Спецификации/40__to_customer_fin/40__Спецификация-Точные машины - заказ 2 - to customer fin #8_2026-n2-горизонт.xlsx

Sheet: SpecificationToCustomerFin
№ | НАИМЕНОВАНИЕ | ОПИСАНИЕ И ХАРАКТЕРИСТИКИ | ЕД ИЗМ. | КОЛ-ВО | ЦЕНА БЕЗ НДС, руб | СТОИМОСТЬ БЕЗ НДС, руб | НДС, руб | ДЛИТЕЛЬНОСТЬ РЕАЛИЗАЦИИ, дней
2.101.1 | Инженерный анализ существующей конструкции изделия. Постаматный вендинговый аппарата, модель «Knowhy» G80/master | Изучение конструкционных, функциональных характеристик Изделия. Получение параметров характеристик. Результатом работ по этапу является: - внутренний технический отчет о выявленных качественных и количественных особенностях данной модели Изделия. | шт | 1 | 150000.00 | 150000.00 | 33000.00 | 14
2.101.2 | Разработка ТЗ №1 на изделие в целом. Постаматный вендинговый аппарата, модель «Knowhy» G80/master | Определение функциональных, технических требований к изделию в целом. Проработка списка корректируемых разделов, требуемых для адаптации ПТК. Результатом работ по этапу является: - утвержденное ТЗ №1 на Изделие, содержащее перечень функциональных, технических требований. | шт | 1 | 30000.00 | 30000.00 | 6600.00 | 7
2.101.3 | Разработка ТЗ №2 на адаптацию ПТК. Постаматный вендинговый аппарата, модель «Knowhy» G80/master | ТЗ на определения реестра технических и организационных мероприятий нацеленных на адаптацию ПТК для управления Изделием. Результатом работ по этапу является: - утвержденное ТЗ №2, на адаптацию ПТК. | шт | 1 | 30000.00 | 30000.00 | 6600.00 | 7
2.102.1 | Адаптация, комплектование и сборка ПТК в соответствии с ТЗ №2. Постаматный вендинговый аппарата, модель «Knowhy» G80/master | Комплектование и сборка ПТК, адаптированного для управления Изделием. Результатом работ по этапу является: - полнофункциональный укомплектованный ПТК для управления изделием. | шт | 1 | 2400000.00 | 2400000.00 | 528000.00 | 80
2.103.1 | Комплексное тестирование аппарата на базе новой системы управления. Постаматный вендинговый аппарата, модель «Knowhy» G80/master | Комплексные испытания одного аппарата с обновленным набором сенсоров, актуаторов и новой системы управления. Результатом работ по этапу является: - протокол комплексных испытаний; - откорректированное на основе тестов прикладное ПО всех уровней, прошедшее проверку реализованной функциональности; - акт готовности изделия к эксплуатации. | шт | 1 | 350000.00 | 350000.00 | 77000.00 | 14
Итог |  |  |  |  |  | 2960000.00 | 651200.00

Sheet: ConfigJSON
IDnum | IDconfig | CONFIG_JSON | COMMENT
1 | gen-spec-to_customer_fin-type4-base | { "TabSpecificationWork": { "1": { "ValidationData": [ { "StrictBlock": true }, { "IDnum": { "fvCheckID": [] } }, { "NUM PROJECT": { "fvCheckNonEmpty": [], "fvCheckTextLength": [13, 25] } }, { "NUM ORDER": { "fvCheckNonEmpty": [], "fvCheckIntegerRange": [1, 100] } }, { "VER COLLECTION": { "fvCheckNonEmpty": [], "fvCheckIntegerRange": [1, 50], "fvCheckSpecUniqueVer": [] } }, { "DESCRIPTION SET": { "fvCheckNonEmpty": [], "fvCheckTextLength": [5, 300] } }, { "IDset": { "fvCheckNonEmpty": [], "fvCheckTextLength": [1, 50] } }, { "NUM SEQUENCE SET": { "fvCheckNonEmpty": [], "fvCheckIntegerRange": [1, 50] } }, { "NUM FULL SET": { "fvCheckNonEmpty": [], "fvCheckTextLength": [3, 7] } }, { "isSHIPPED": { "fvCheckNonEmpty": [], "fvCheckTextLength": [4, 5] } }, { "HASH COLLECTION": { "fvCheckNonEmpty": [], "fvCheckTextLength": [32, 55] } }, { "NAME PRODUCT": { "fvCheckNonEmpty": [], "fvCheckTextLength": [3, 300] } }, { "DESCRIPTION PRODUCT": { "fvCheckNonEmpty": [], "fvCheckTextLength": [10, 1000] } }, { "BRAND": { "fvCheckNonEmpty": [], "fvCheckTextLength": [3, 50] } }, { "SUPPLIER": { "fvCheckNonEmpty": [], "fvCheckTextLength": [3, 50] } }, { "ARTICLE SUPPLIER": { "fvCheckNonEmpty": [], "fvCheckTextLength": [3, 50] } }, { "ARTICLE INTERNAL": { "fvCheckNonEmpty": [], "fvCheckTextLength": [20, 20] } }, { "UNITS": { "fvCheckNonEmpty": [], "fvCheckTextLength": [0, 2] } }, { "QUANTITY SET": { "fvCheckNonEmpty": [], "fvCheckIntegerRange": [1, 50] } }, { "QUANTITY SHIPPED SET": { "fvCheckNo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 | DSL - конфигурация предназначена для генерации 'to customer fin' спецификации в соответствии с новыми командами и требованиями ETL процессора версии - 'rev.05 v02' а также она (конфигурация) явялется разновидность 'type 4' таких спецификаций (см документацию HorizonBI). Днная спецификация не КАСТОМНАЯ (!) это 'база', не предназначенная под конкретный проект, но содержащая основные элменты обработки, трансформации, фильтрации и валидации.
