Konkery/Project-8_2026-N2-HORIZON/03__Проект/77__Контрагенты/01__Конструкторы/03__Out/Перечень оборудования для бокса и размеры.xlsx

п/п | наименование | кол. В боксе | Ш, в мм | В, в мм | Г, в мм | url | 3D модель | PDF
1 | Интеллектуальный источник питания DRS-240-24 | 2 | 85.5 | 125.2 | 129.2 | https://www.mean-well.ru/store/DRS-240-24/ | https://www.mean-well.ru/uploads/docs/DRS-240-24-3D_model_DRS-240-24-17657.zip | https://www.mean-well.ru/uploads/files/datasheets/DRS-240-24.pdf
2 | Модуль резервного питания WB-UPS v.3 | 1 | 36 | 90 | 58 | https://wirenboard.com/ru/contents/product/wb-ups-v3 | https://wiki.wirenboard.com/wiki/%D0%A4%D0%B0%D0%B9%D0%BB:WB-Library.svg.zip | https://wiki.wirenboard.com/wiki/images/a/a9/WB-UPS_v.3_Backup_power_supply_manual.pdf
3 | Delta Аккумуляторная батарея DTM 1205 | 3 | 90 | 101 | 70 | https://www.delta-batt.com/catalog/statsionarnye/dtm/dtm-1205/ |  | https://www.delta-batt.com/upload/iblock/9a6/vhvqfz4xj4uxn21ghqbwhxvuljvz4h65/TI_DTM_1205_RU.pdf
4 | модуль i/o Kincony A868-A16v3 | 6 | 134 | 198 | 45 | https://www.kincony.com/images/KC868-A16v3/KC868-A16v3-shell-1.jpg | https://www.kincony.com/images/KC868-A16v3/KC868-A16v3-shell-3.jpg
5 | транзисторный модуль | 2 | 166 | 85 | 48 | https://ali.click/h4e3e17
6 | Хаб НУ/СУ/ВУ IPCBOX-CM5-A | 3 | 39.5 | 136 | 92 | https://www.waveshare.com/ipcbox-cm5-a.htm
7 | Хаб НУ/СУ/ВУ CM4-ETH-RS485-BOX-B | 3 | 98 | 131 | 32 | https://www.waveshare.com/cm4-eth-rs485-box-b.htm | https://files.waveshare.com/upload/f/f6/CM4-ETH-RS485-BASE-B_3D.zip
8 | Wi-Fi роутер MIKROTIK L009UIGS-2HaXD-IN | 1 | 220 | 125 | 22 | https://mikrotik.wiki/wiki/MikroTik_L009UiGS-2HaxD-IN | https://sketchfab.com/3d-models/l009uigs-2haxd-in-262d575716ca49cd9ef7ebcdd9e4d37e
9 | Вентилятор ID-COOLING TF-12025-Pro 120мм | 3 | 120 | 120 | 25 | https://www.dns-shop.ru/product/0442e0f58a6aed20/ventilator-id-cooling-tf-series-tf-12025-pro-black-cernyj/
10 | Датчик температуры и влажности ДВТ-05.RS.З.Н | 1 | 16 | 140 | 16 | https://relsib.com/product/datchik-temperatury-i-otnositelnoj-vlazhnosti-dvt-05rszn?offer=26358 |  | https://relsib.com/rls-documents/passports/DVT_05N.K.pdf
11 | кронштейн ONKRON R4 |  | 230 | 420 | 52 | https://onkron.ru/product-onkron-kronshtejn-dlja-televizora-10-27-naklonno-povorotnyj-chjornyj-r4 |  | https://onkron.com/manual/files/Manual/R4-B/R4_%D0%905_Manual_20230222.pdf
12 | R10-MF (QR) бесконтактный считыватель RusGuard |  | 48 | 144 | 23 | https://www.rgsec.ru/card-readers/r10-mf-qr |  | https://www.rgsec.ru/wp-content/uploads/docs/R10-MF-QR-Pas_v2.pdf
13 | Монитор 21,5 inch |  | 525 | 320 | 45 | https://www.ozon.ru/product/rus-win-21-5-monitor-zz21-5g1-zz-ips-1920x1080-full-hd-75-gts-chernyy-matovyy-1752081258/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
14 | Интеллектуальный источник питания NLS-6012 | 2 | 45 | 109 | 115 | https://www.reallab.ru/catalog/power/nls-6012/ | https://www.reallab.ru/images/editor/downloads/3d_models/nls_ps_15_60/NLS-6024-CAN_3D_RealLab.zip | https://www.reallab.ru/catalog/power/nls-6024/
15 | Контроллер адресной ленты Antex MB2WS | 1 | 35 | 88 | 62 | https://antexcloud.ru/#MB2WS
16 | ICP DAS tDS-735i | 1 | 52 | 95 | 27 | https://icp-das.ru/product/tds-735i |  | https://files.icp-das.ru/files/1/1205/36824245/original/Datasheet_tDS_700__34057833.pdf?1729523567
 | Прошу обратить внимание на позиции 6 и 7. Данные модели корпусов могут применяться в шести вариациях.
 | Например: 3 модели корпуса только CM5-A, или 2 модели BOX-B и одна CM5-А, ну т.д.
