Konkery/Project-8_2026-N2-HORIZON/03__Проект/77__Контрагенты/01__Конструкторы/03__Out/13. монитор 21.5/3D model/TS2236L-2UT-APM (без уголков).STEP

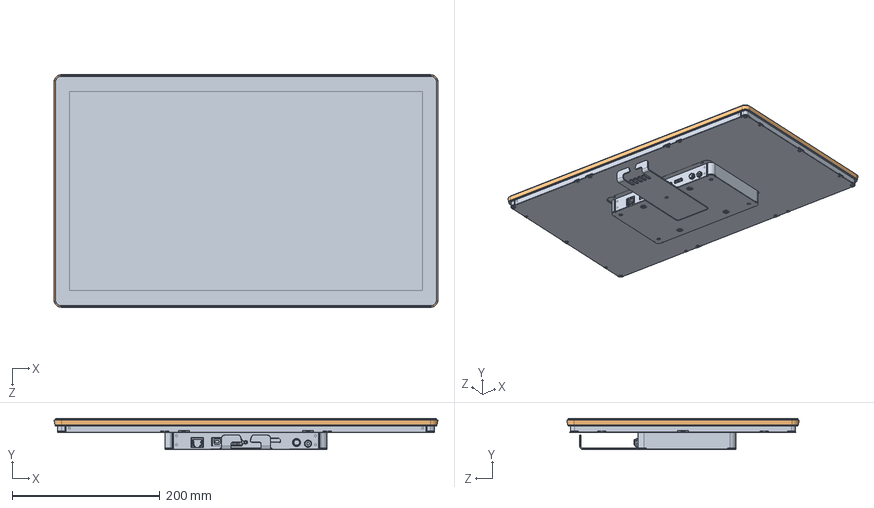
[picture p32: CAD file, 2026-10-20]
03__Проект/77__Контрагенты/01__Конструкторы/03__Out/13. монитор 21.5/3D model/TS2236L-2UT-APM (без уголков).STEP
519.9 x 42.4 x 314.9 mm
EGG_SHELL_1
WIP-FR1-APM-22
