Konkery/Project-8_2026-N2-HORIZON/03__Проект/77__Контрагенты/01__Конструкторы/03__Out/14. источник питания NLS-6012/3d model/NLS-6024-CAN.stp

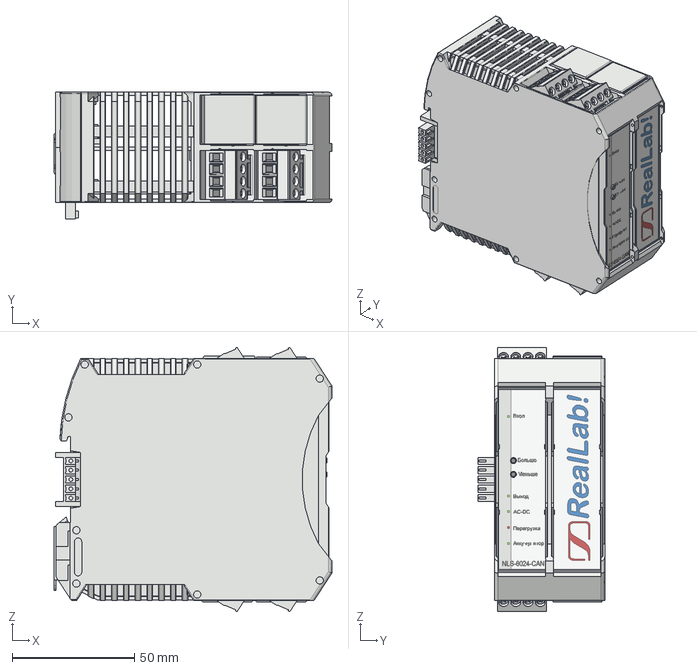
[picture p33: CAD file, 2026-10-20]
03__Проект/77__Контрагенты/01__Конструкторы/03__Out/14. источник питания NLS-6012/3d model/NLS-6024-CAN.stp
113.7 x 51.8 x 108.0 mm
