Konkery/Project-8_2026-N2-HORIZON/03__Проект/77__Контрагенты/01__Конструкторы/03__Out/2. WB-UPS v.3/3d model/WB-UPSv3.dxf

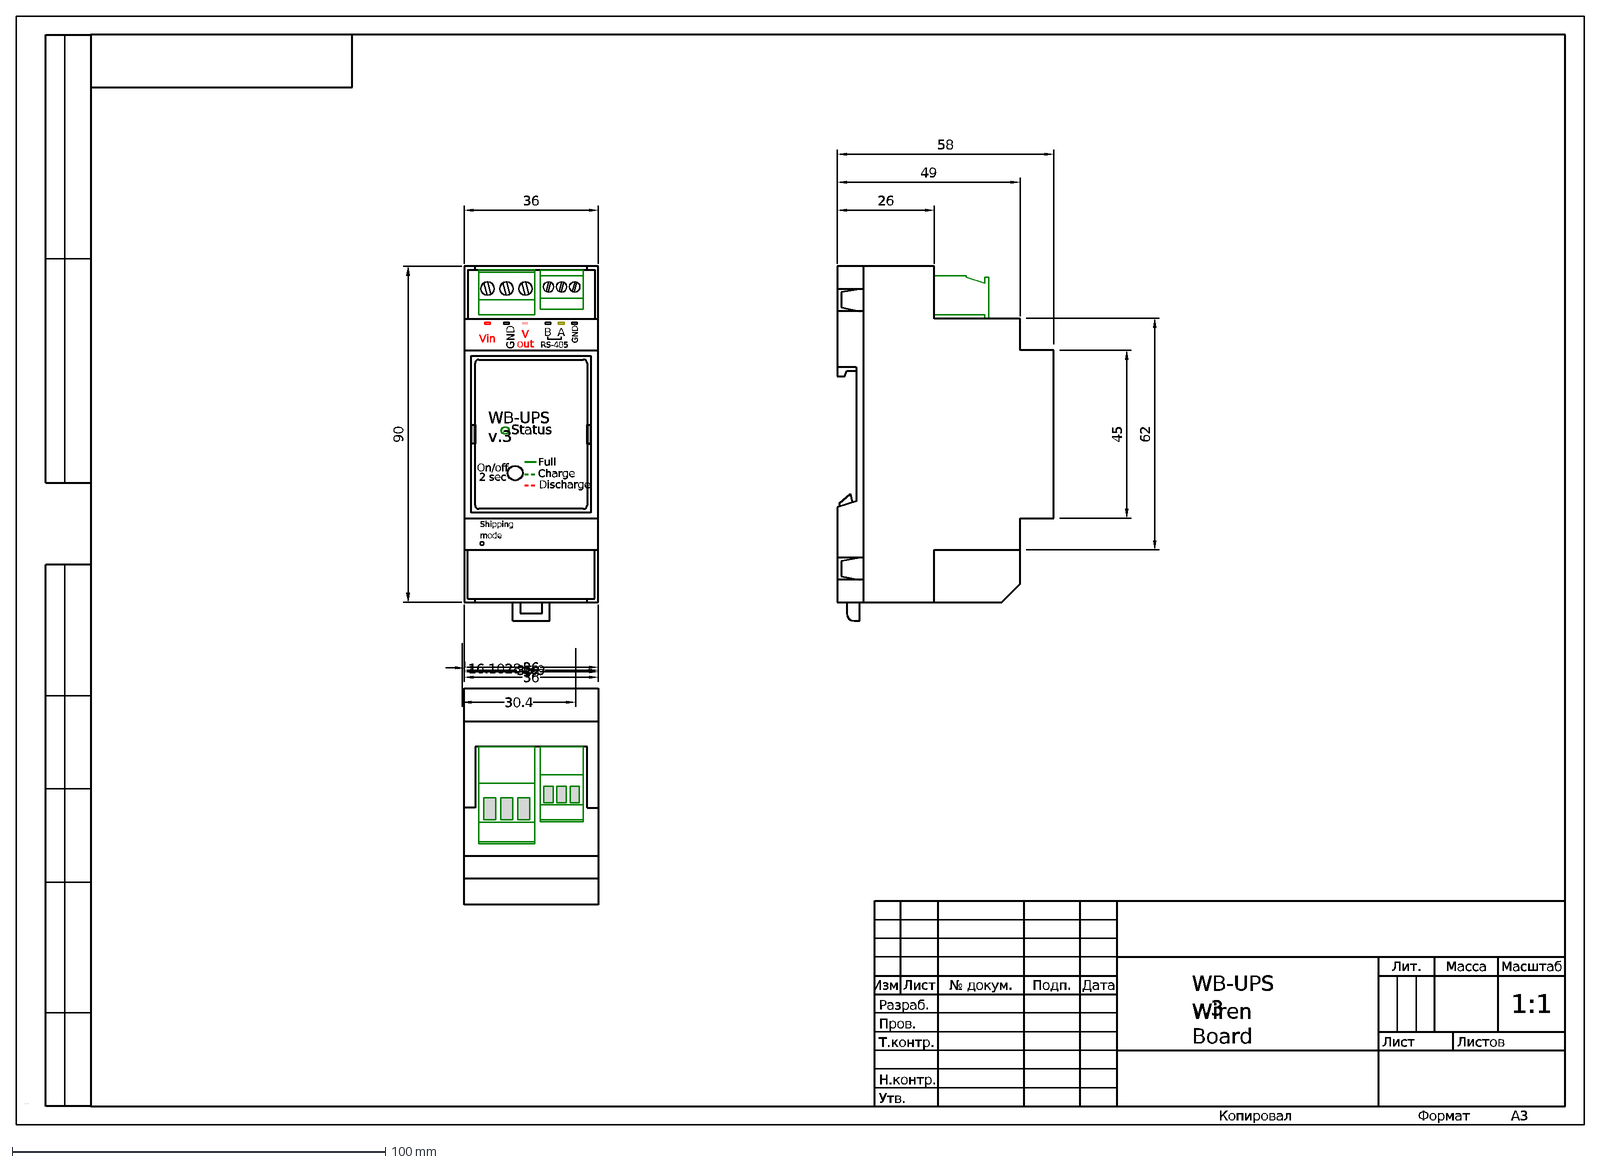
[picture p34: CAD file, 2026-10-20]
03__Проект/77__Контрагенты/01__Конструкторы/03__Out/2. WB-UPS v.3/3d model/WB-UPSv3.dxf
WB-UPS v.3
Копировал
Формат
A3
1:1
Листов
Утв.
Лист
Изм.
Пров.
Н.контр.
№ докум.
Т.контр.
Разраб.
Подп.
Дата
Лит.
Масштаб
Масса
Shipping mode
Vin
V
B
GND
Wiren Board
out
36
90
26
45
62
49
58
16.1028
35.9
30.4
A
RS-485
Status
On/off 2 sec
Full
Charge
Discharge
