Konkery/Project-8_2026-N2-HORIZON/03__Проект/77__Контрагенты/01__Конструкторы/03__Out/7. Хаб НУ_СУ_ВУ версия 2/3D model/CM4-ETH-RS485-BASE-B.step

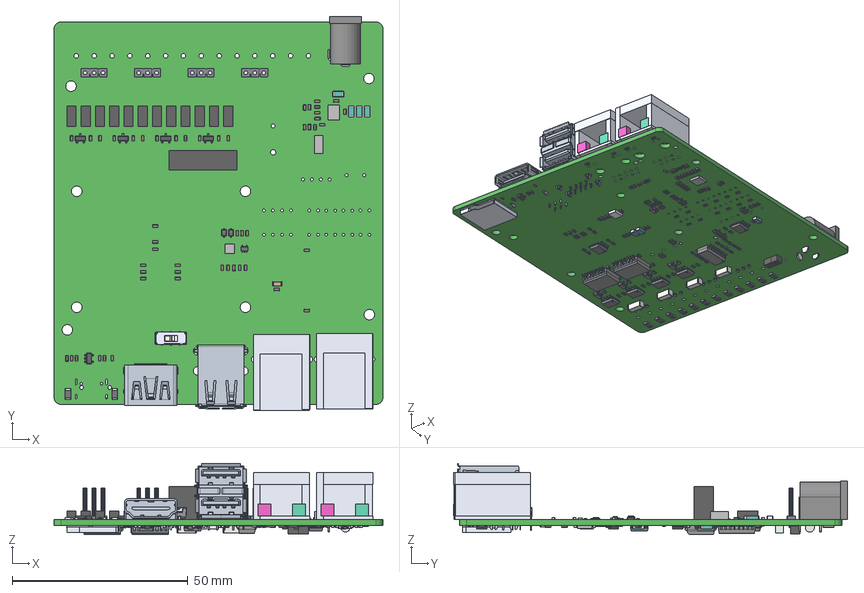
[picture p35: CAD file, 2026-10-20]
03__Проект/77__Контрагенты/01__Конструкторы/03__Out/7. Хаб НУ_СУ_ВУ версия 2/3D model/CM4-ETH-RS485-BASE-B.step
93.6 x 112.1 x 20.2 mm
Extruded x 97
BODY-SOT x 4
LEAD-SOT x 20
LEAD-DUMMY x 4
RESC1608(0603) x 97
PinsArrayLR
CAPC1608(0603) x 65
SW3dPS-dc_range_-_dc_connector[4840.2201]
INDC3216(1206) x 7
723095044blf
ALSRobot-SOT23 x 8
SW3dPS-SOD-323 x 2
User_Library-CR3216-1206 x 14
User_Library-sop-8 x 6
User_Library-SOIC16_Wide_JEDEC_MS-013AA x 2
SW3DPS-SOT-23-5-DEFAULT x 2
User_Library-SC70-5-1
Pin1 x 2
Pin2 x 14
Pin4 x 2
Pin3 x 2
User_Library-YC124-1
User_Library-MMP221_MMP221
User_Library-MMP221_MMP221_SM
User_Library-MMP221_MMP221_PP
User_Library-MMP221_MMP221_PIN x 3
