Konkery/Project-8_2026-N2-HORIZON/03__Проект/77__Контрагенты/01__Конструкторы/03__Out/Эскизы в 3D/ниша вентиляция.stl

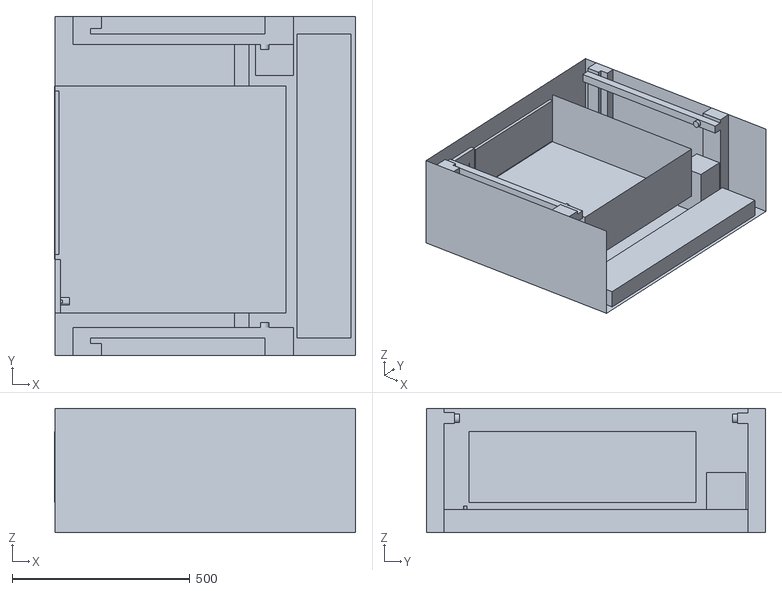
[picture p36: CAD file, 2026-10-20]
03__Проект/77__Контрагенты/01__Конструкторы/03__Out/Эскизы в 3D/ниша вентиляция.stl
847.0 x 955.0 x 350.0
