Konkery/Project-8_2026-N2-HORIZON/03__Проект/77__Контрагенты/01__Конструкторы/03__Out/Эскизы в 3D/ниша компоновка(2).dxf

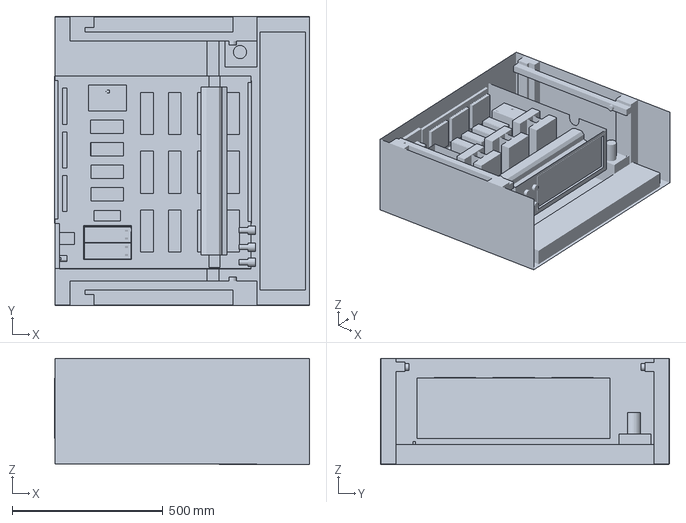
[picture p37: CAD file, 2026-10-20]
03__Проект/77__Контрагенты/01__Конструкторы/03__Out/Эскизы в 3D/ниша компоновка(2).dxf
847.0 x 959.0 x 352.0 mm
