Konkery/Project-8_2026-N2-HORIZON/03__Проект/77__Контрагенты/01__Конструкторы/03__Out/Эскизы в 3D/вендинг аппарат 4.stl

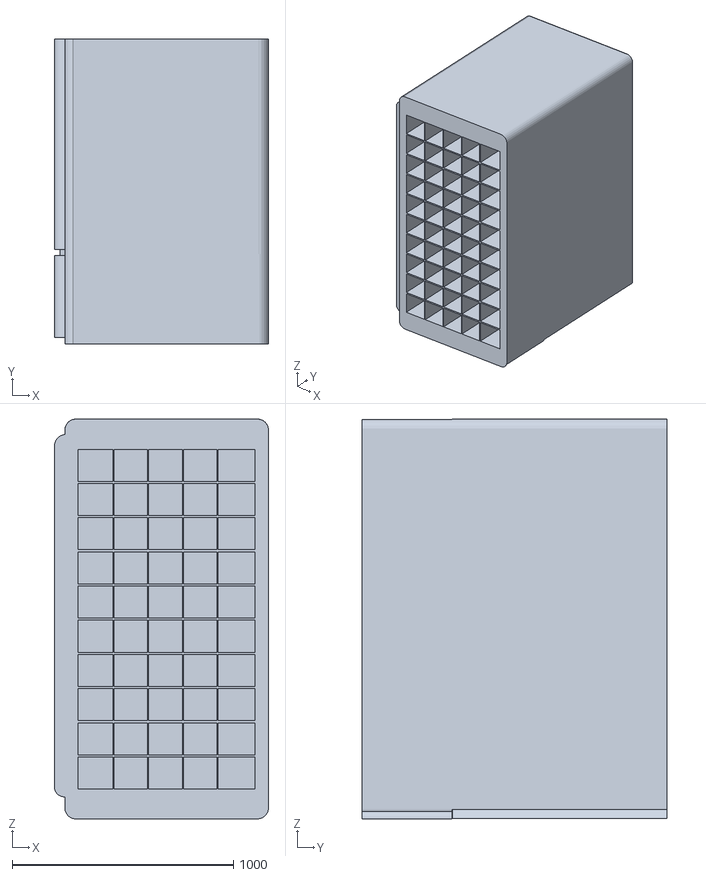
[picture p38: CAD file, 2026-10-20]
03__Проект/77__Контрагенты/01__Конструкторы/03__Out/Эскизы в 3D/вендинг аппарат 4.stl
967.4 x 1377.0 x 1807.6
