Konkery/Project-8_2026-N2-HORIZON/03__Проект/77__Контрагенты/01__Конструкторы/03__Out/Эскизы в 3D/ниша аппарата 2.stl

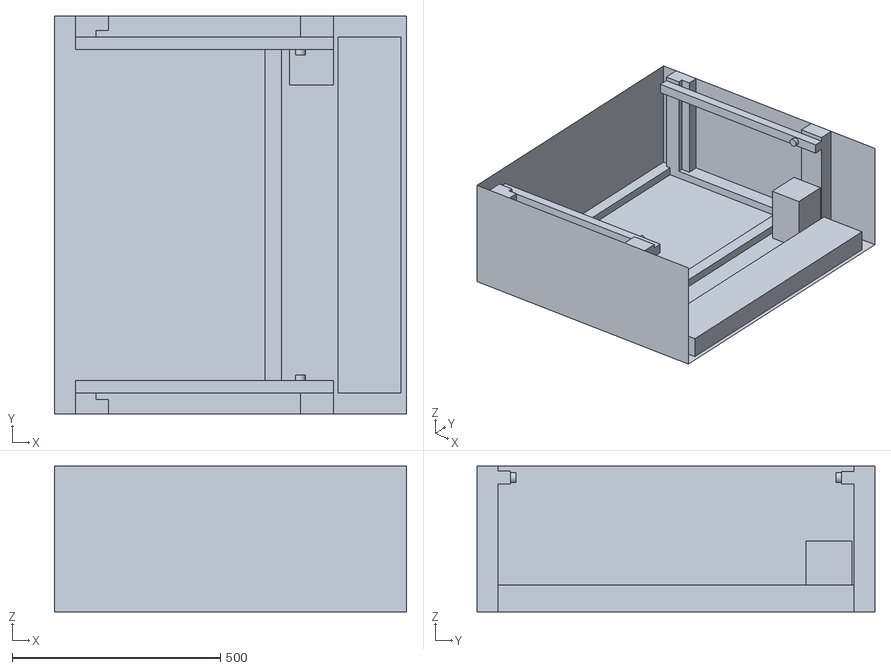
[picture p39: CAD file, 2026-10-20]
03__Проект/77__Контрагенты/01__Конструкторы/03__Out/Эскизы в 3D/ниша аппарата 2.stl
845.0 x 955.0 x 350.0
