Konkery/Project-8_2026-N2-HORIZON/(list of files, cad)

Other CAD files:
03__Проект/77__Контрагенты/01__Конструкторы/03__Out/Эскизы в 3D/вендинг аппарат 4.dxf
03__Проект/77__Контрагенты/01__Конструкторы/03__Out/Эскизы в 3D/вендинг аппарат 4.skp
03__Проект/77__Контрагенты/01__Конструкторы/03__Out/Эскизы в 3D/ниша аппарата 2.dxf
03__Проект/77__Контрагенты/01__Конструкторы/03__Out/Эскизы в 3D/ниша аппарата 2.skp
03__Проект/77__Контрагенты/01__Конструкторы/03__Out/Эскизы в 3D/ниша вентиляция.skp
