Konkery/Project-8_2026-N2-HORIZON/03__Проект/77__Контрагенты/01__Конструкторы/03__Out/11. кронштейн ONKRON R4/Документы/R4_А5_Manual_20230222.pdf

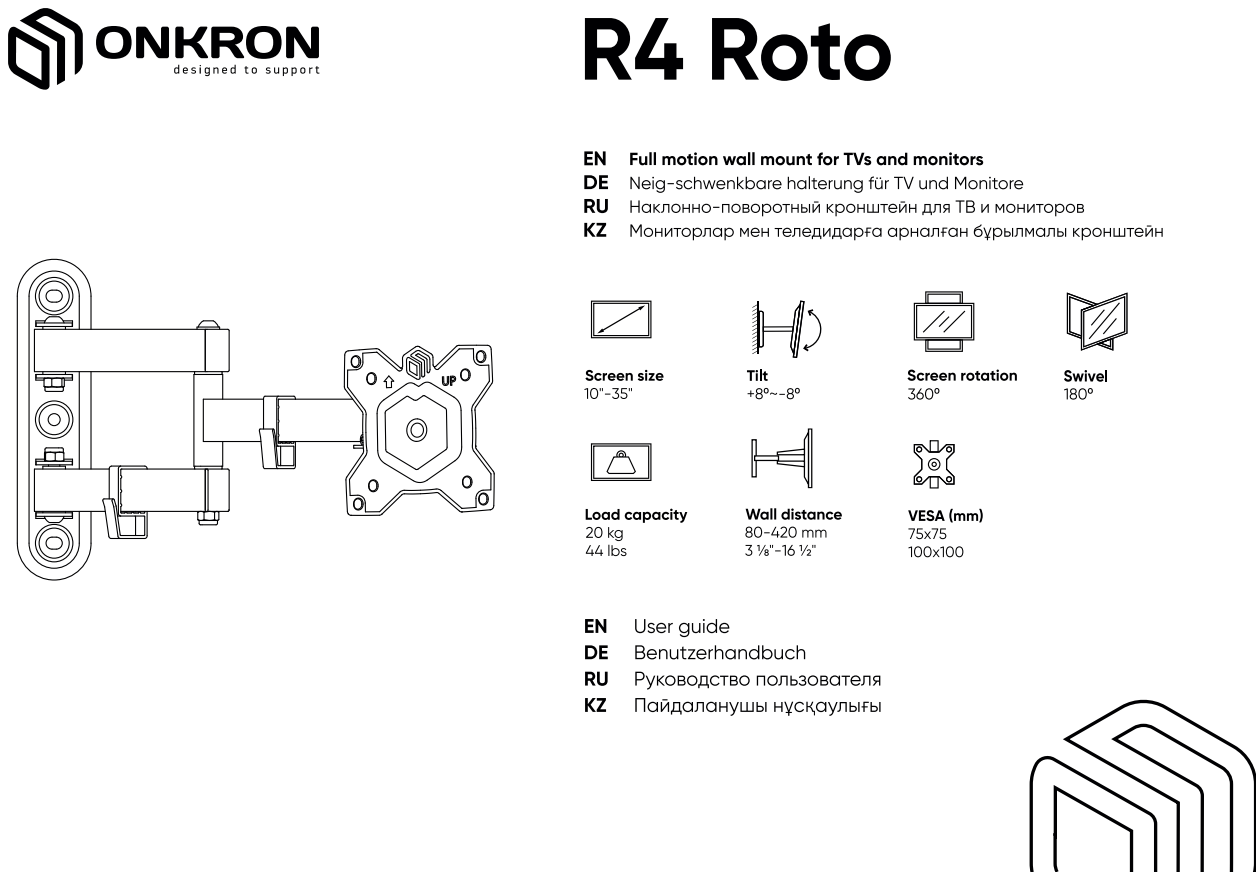
[picture p77: page 1]

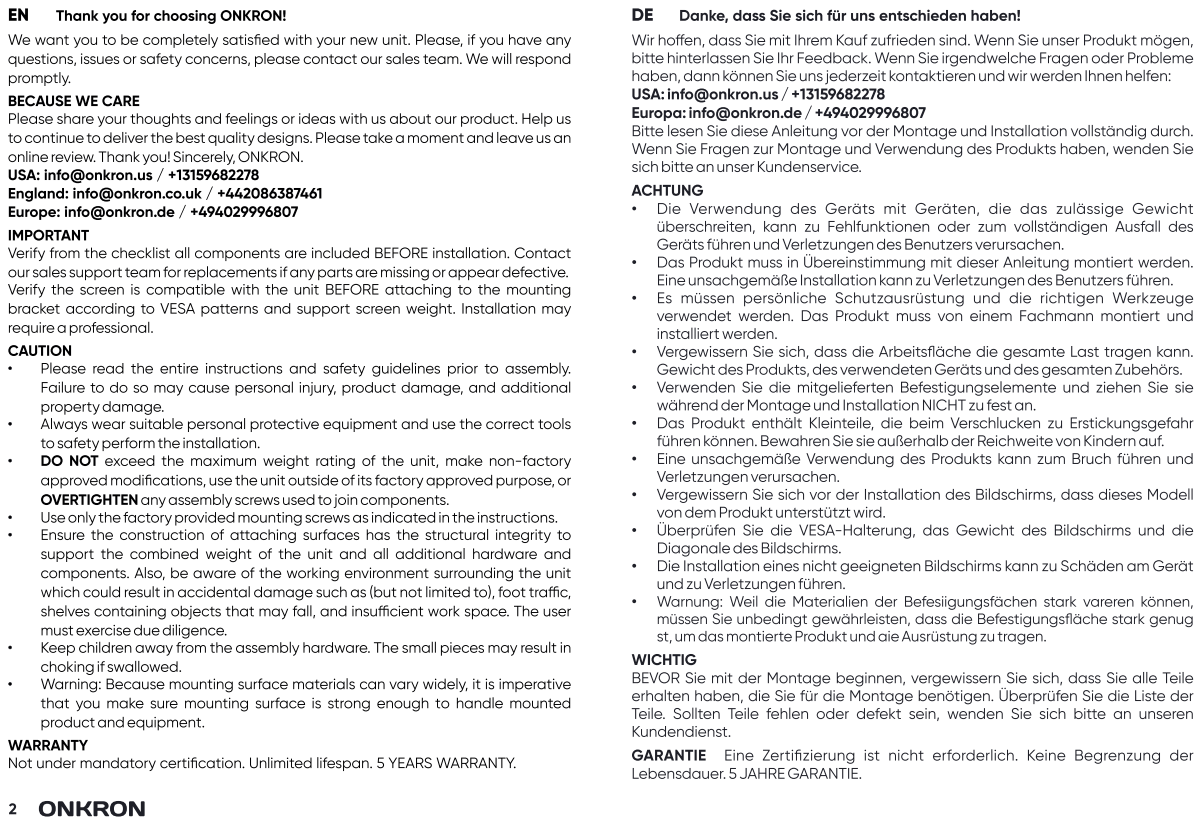
[picture p78: page 2]

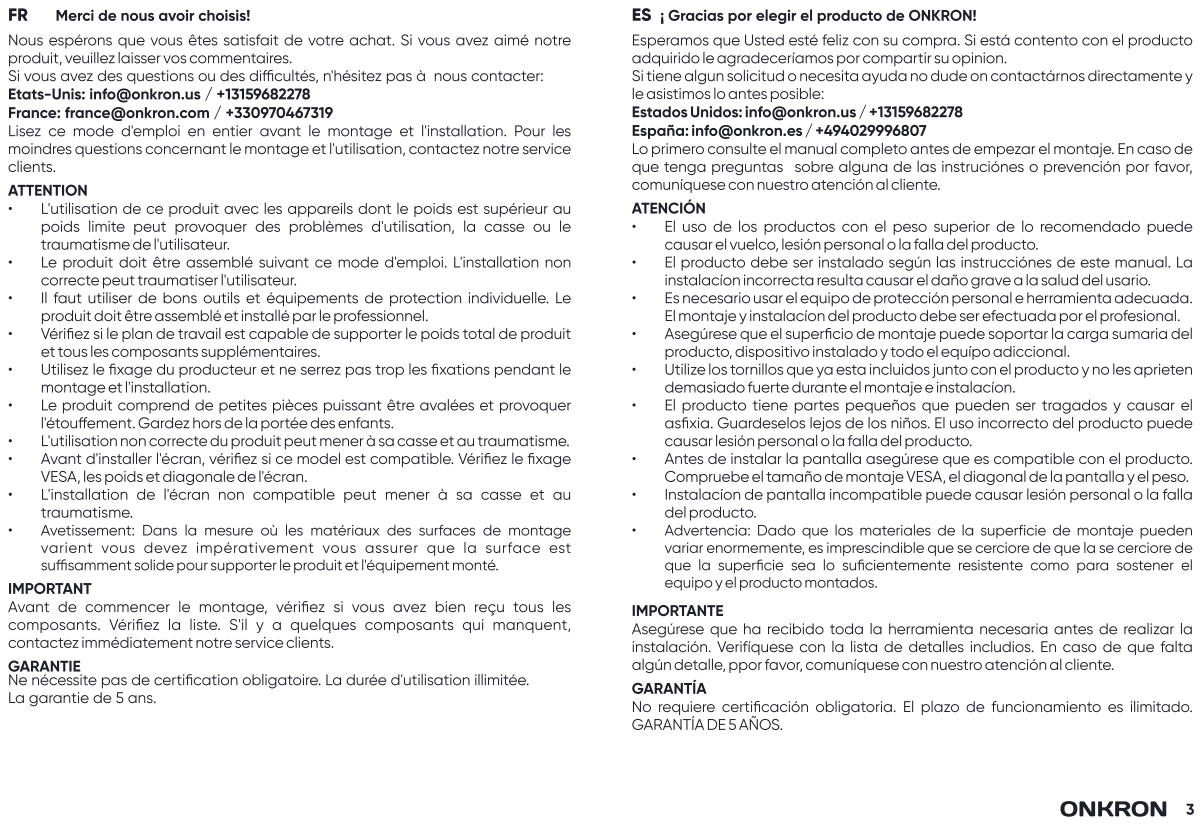
[picture p79: page 3]

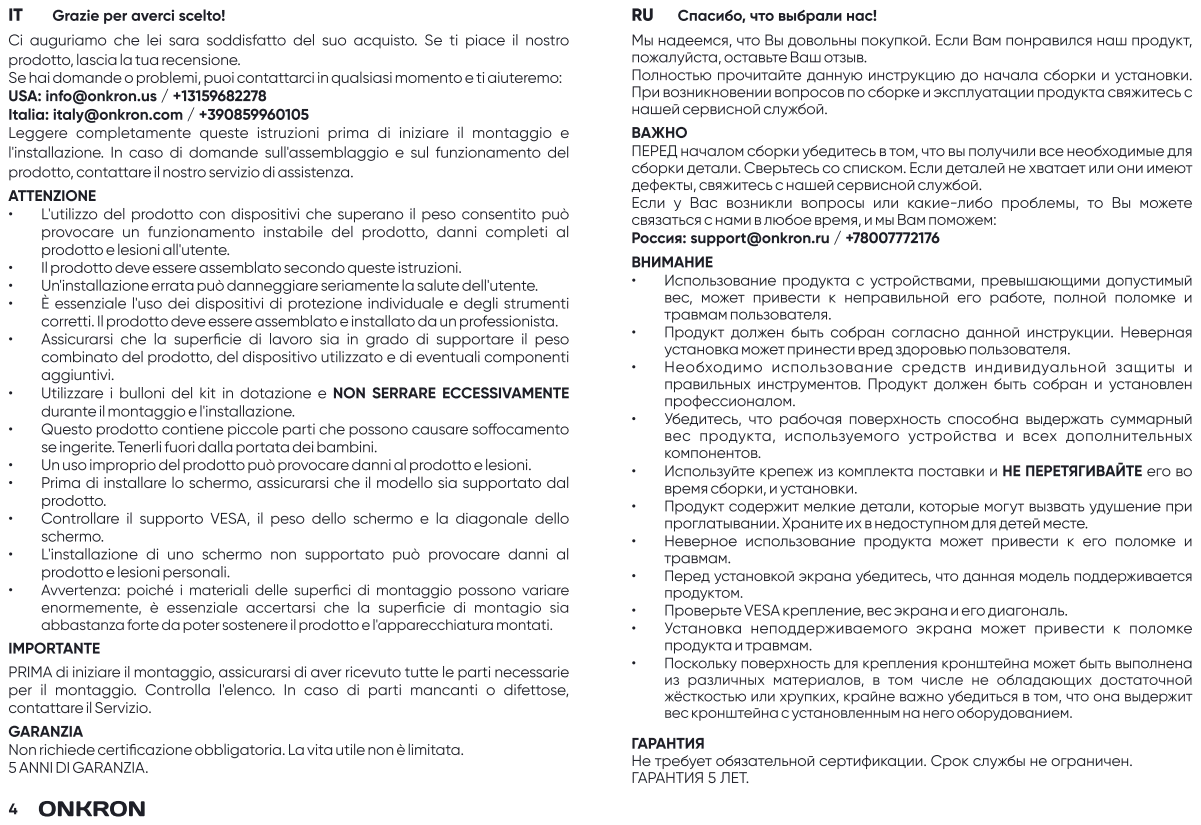
[picture p80: page 4]

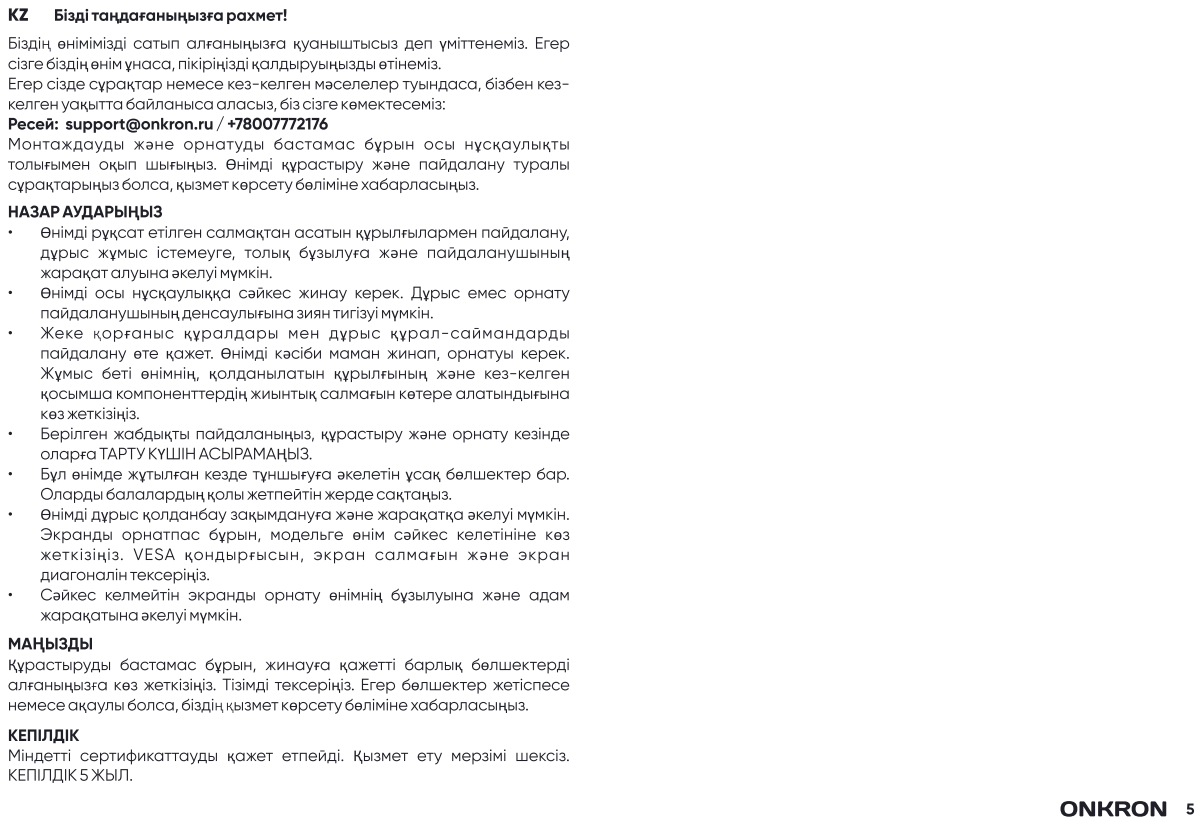
[picture p81: page 5]

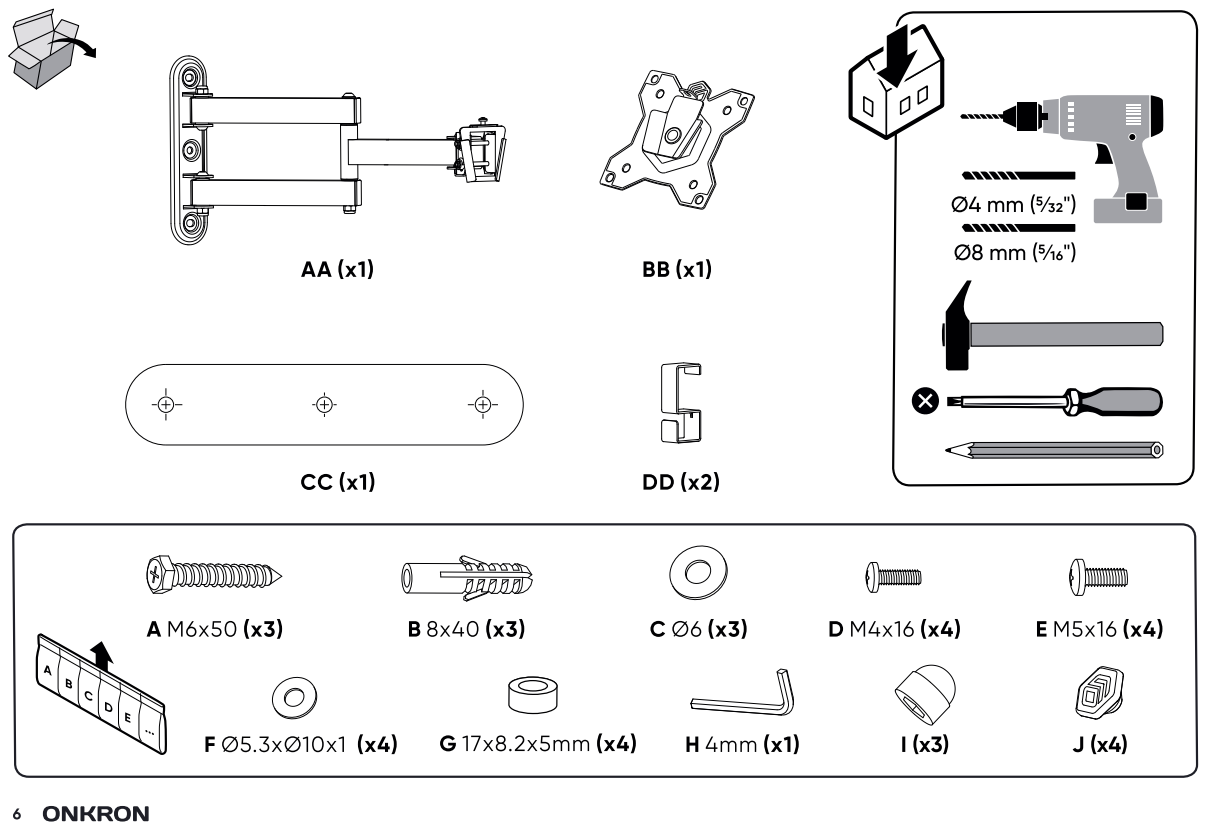
[picture p82: page 6]

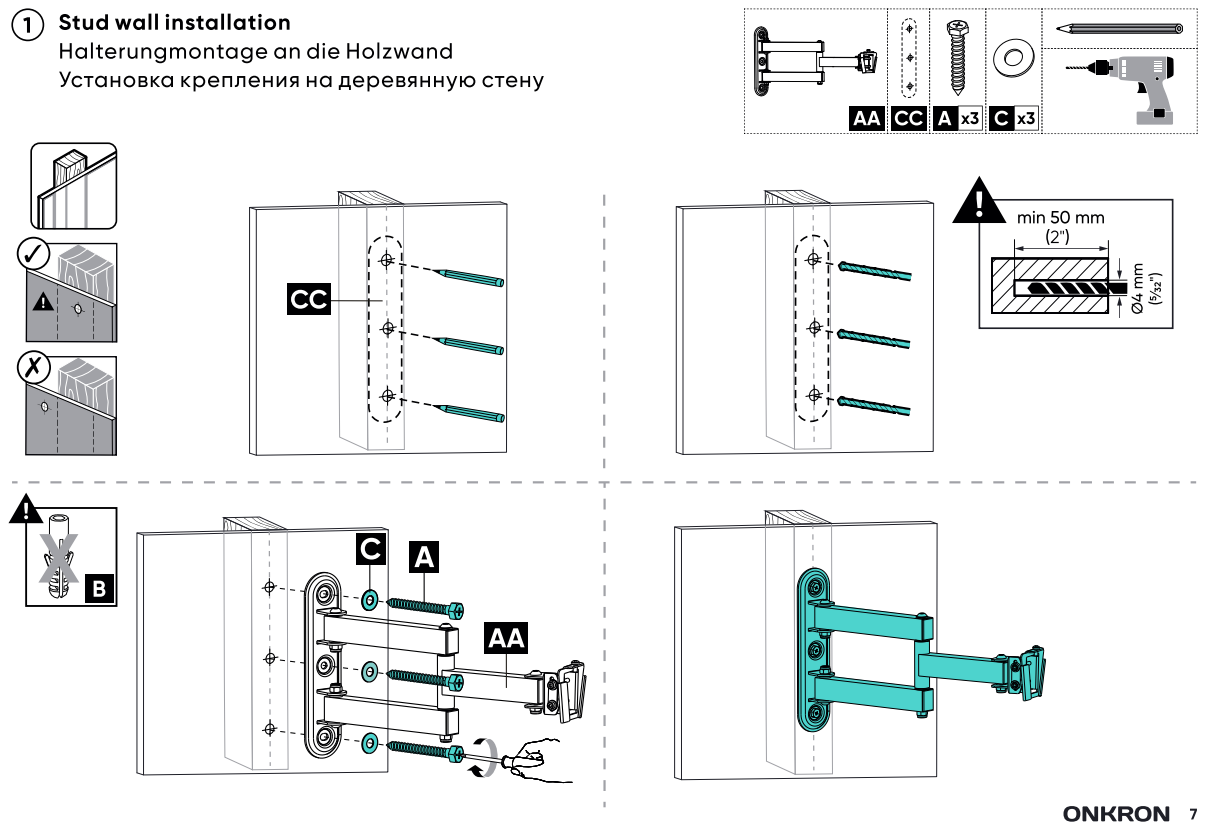
[picture p83: page 7]

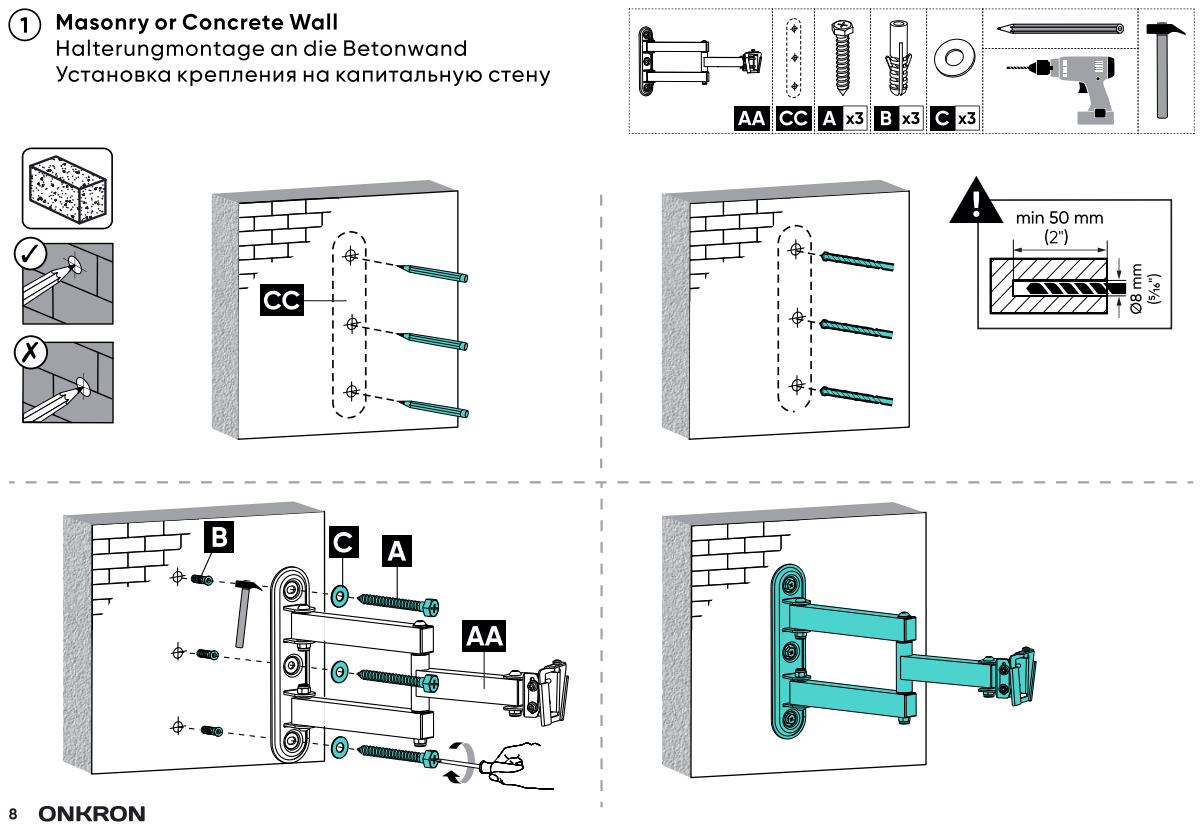
[picture p84: page 8]

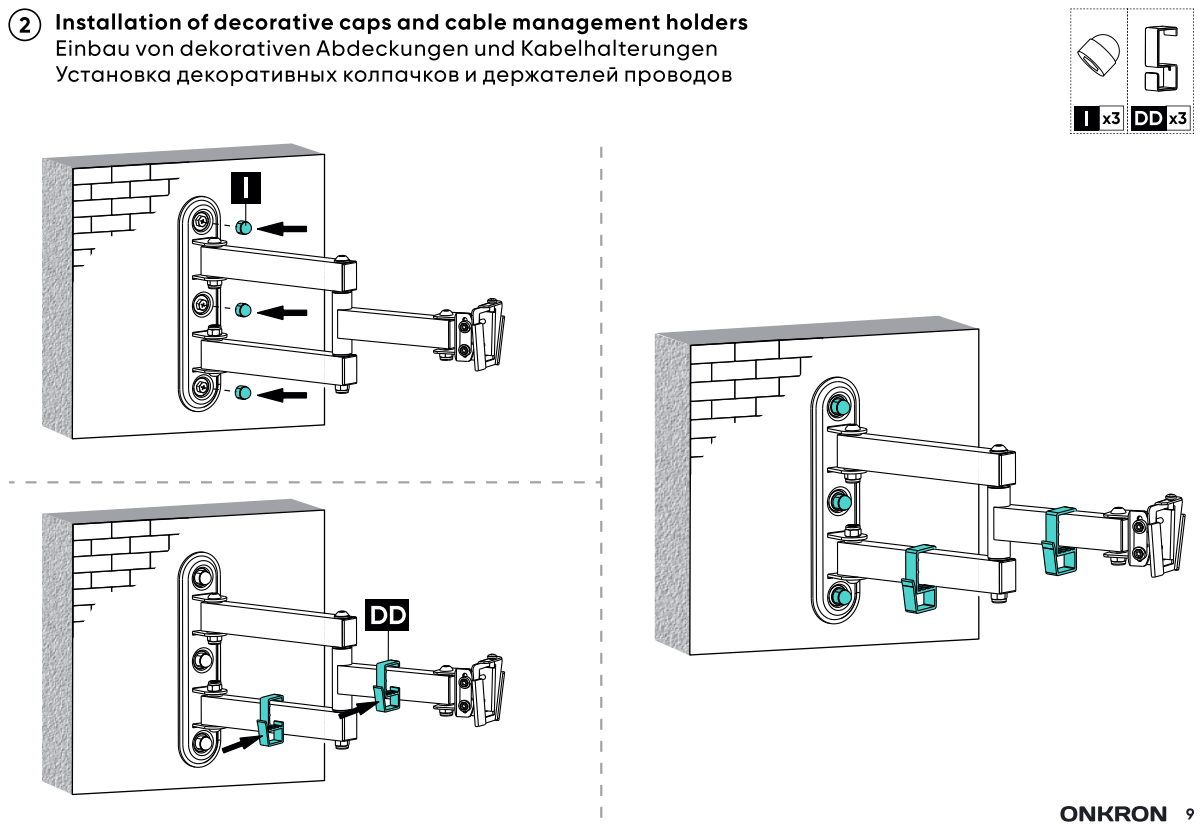
[picture p85: page 9]

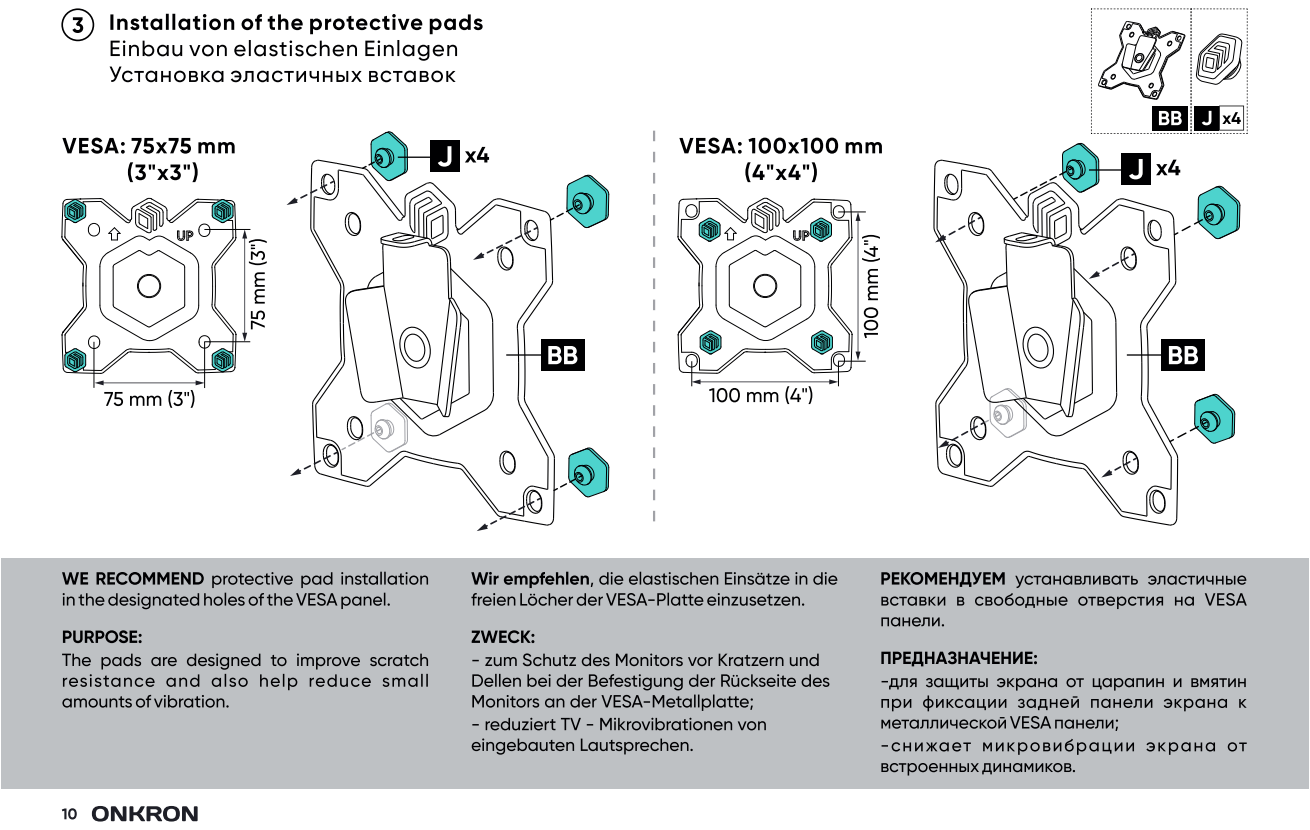
[picture p86: page 10]

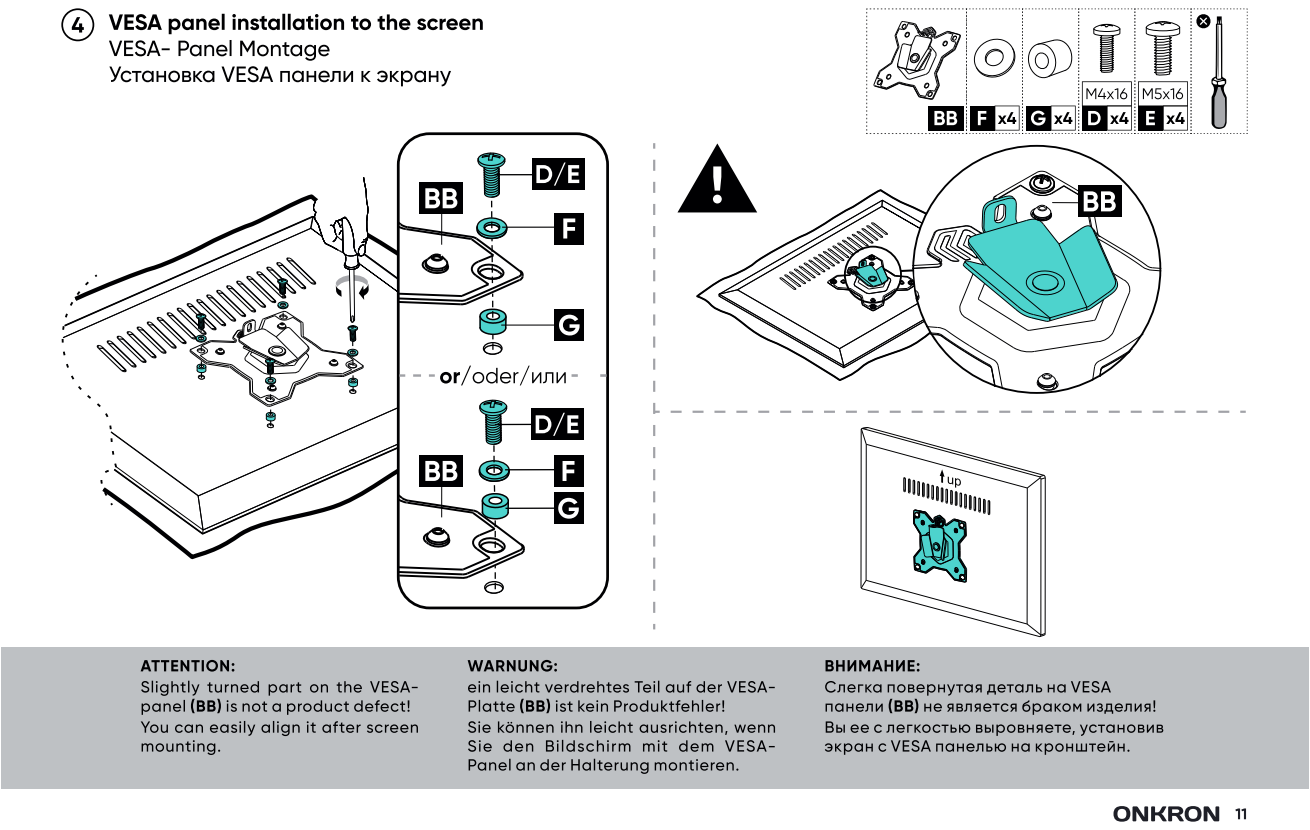
[picture p87: page 11]

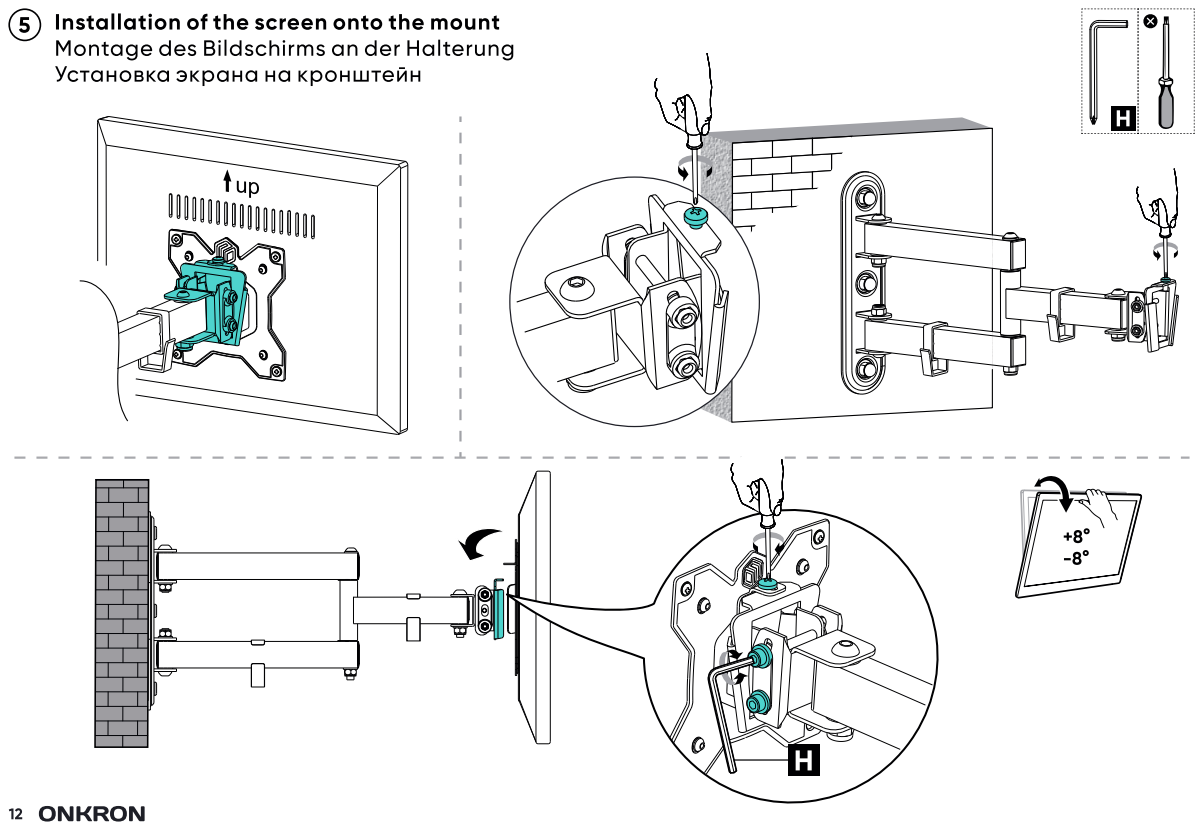
[picture p88: page 12]

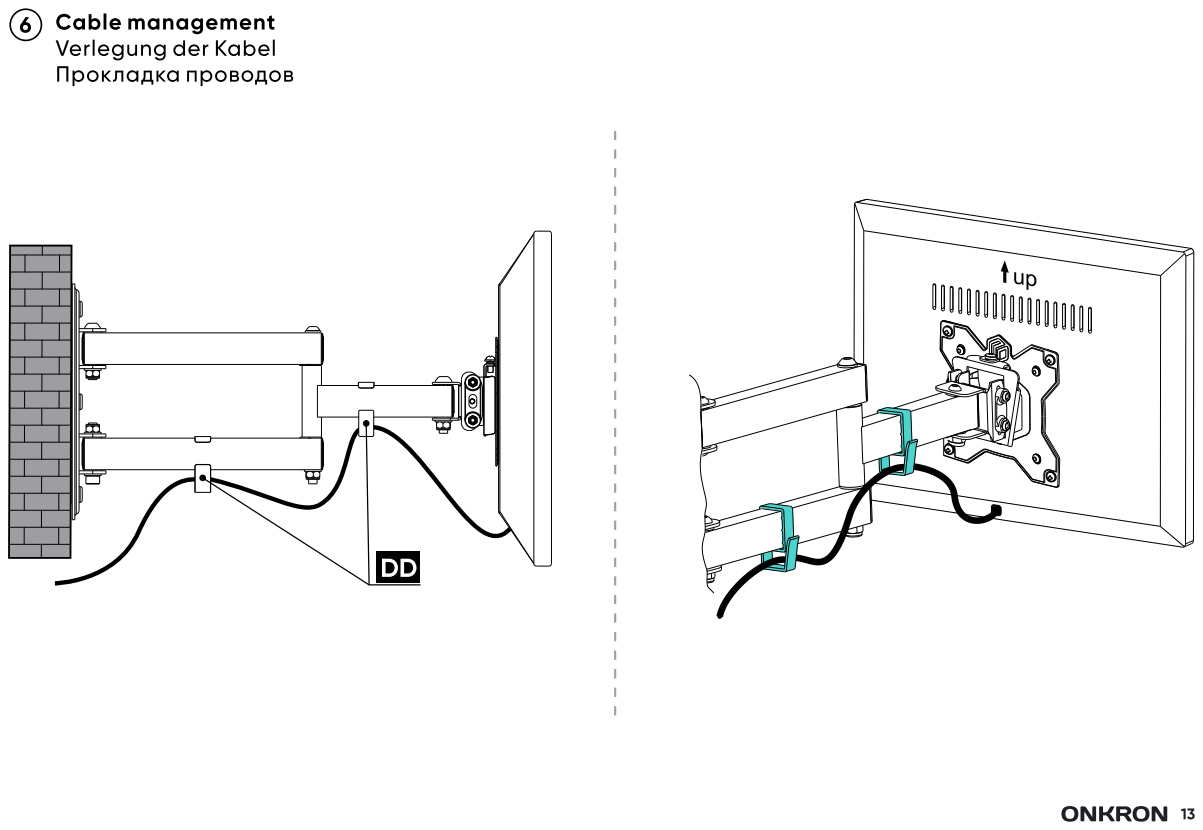
[picture p89: page 13]

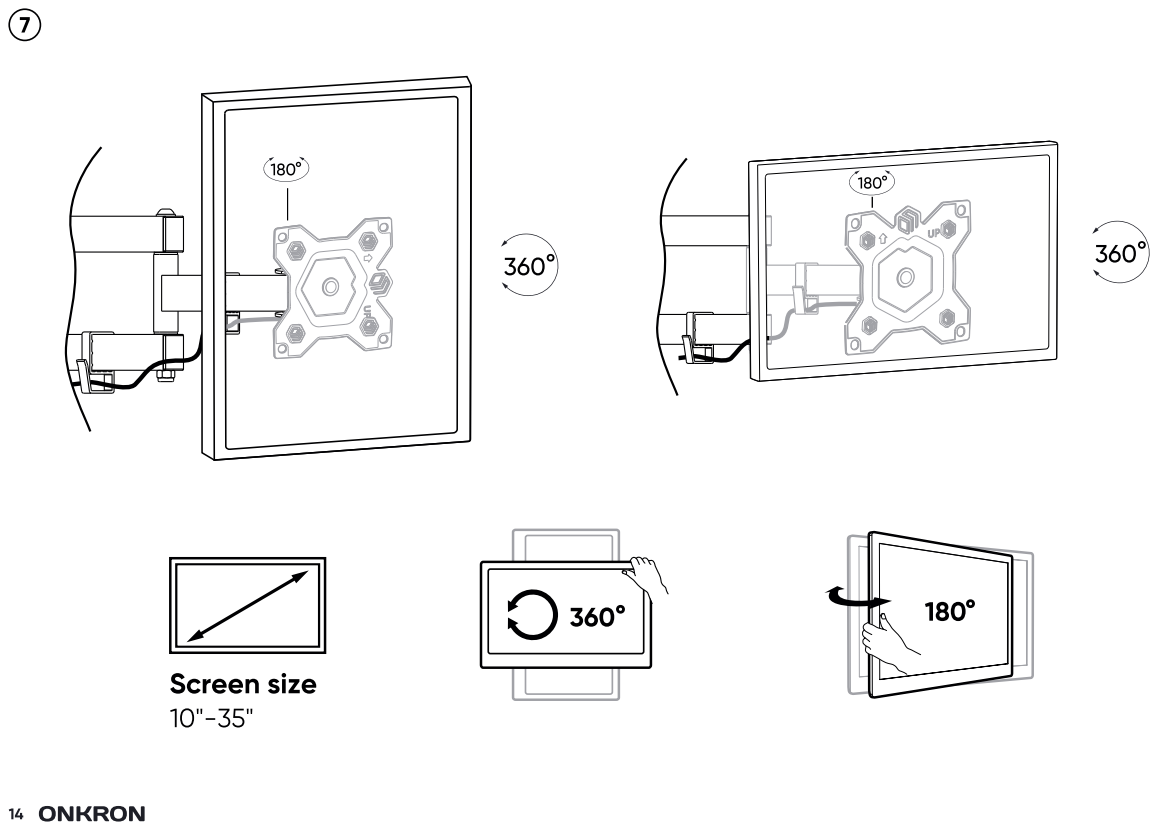
[picture p90: page 14]

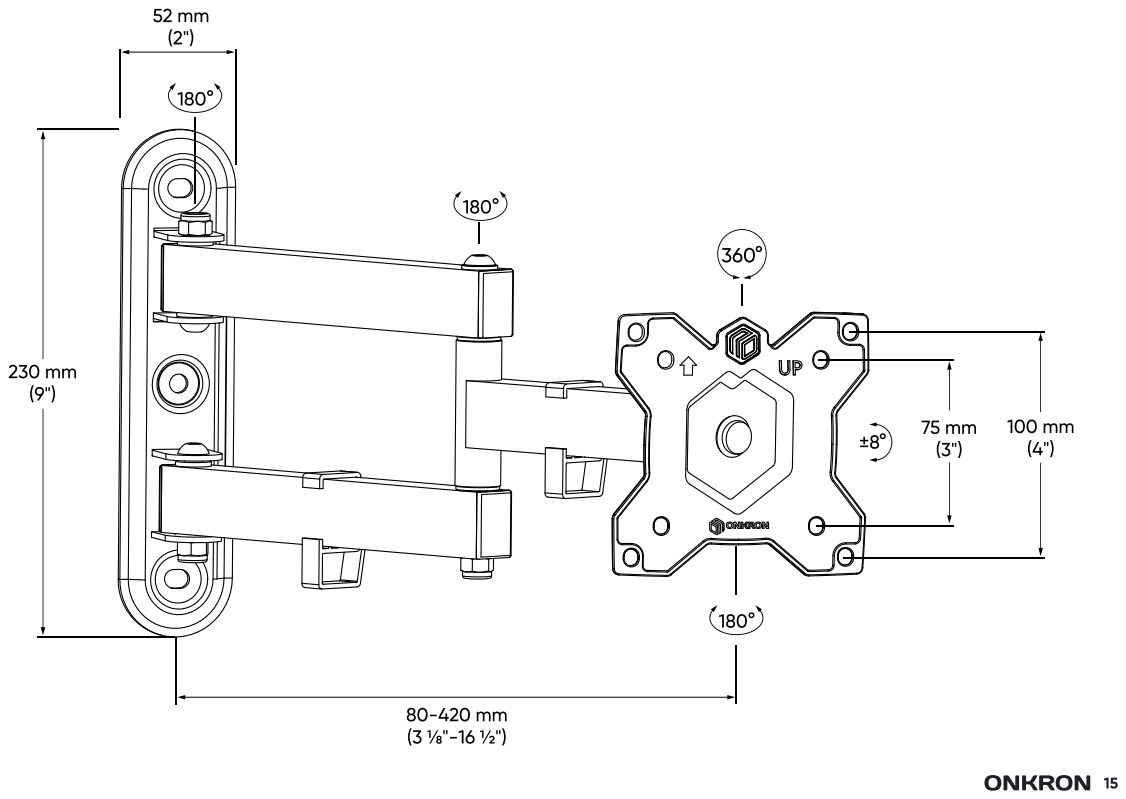
[picture p91: page 15]

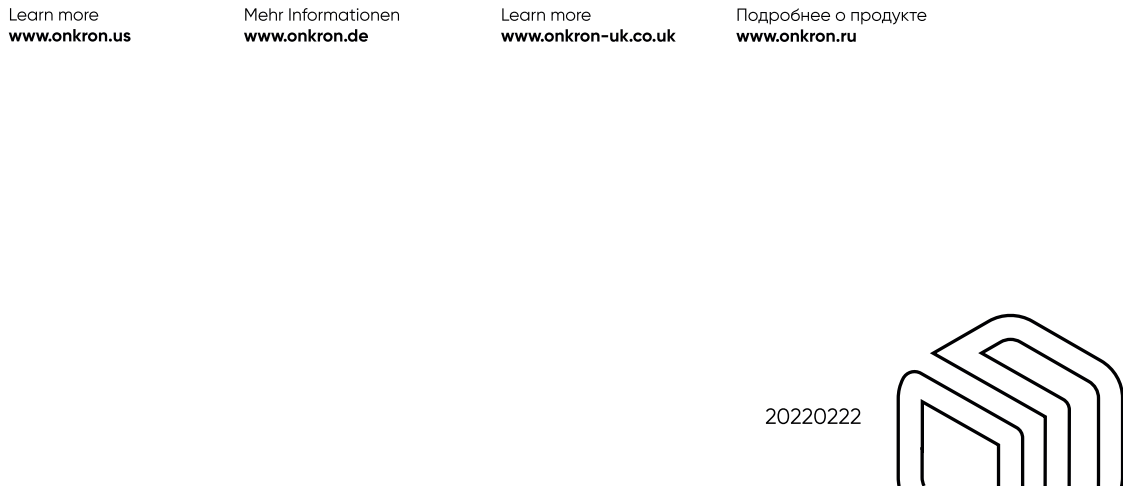
[picture p92: page 16]
