Konkery/Project-8_2026-N2-HORIZON/(commit log)

2026-09-18 Инициализация проекта 8_2026-N2 (Horizon VM): базовая структура, спецификации и исходная документация
2026-10-20 feat: манифест заказа, актуализация план-графика (120 к.д., ООО «ТМ ТЕХНОЛОГИЯ»), полная git-фиксация ИРП N2
    - AGENTS.md — системный манифест заказа N2 v1.0 по образу манифеста рамки N0 и структуры N1 (паспорт, экономика, этика, спецификации, ИРП, статусы)
    - План_проекта_8_2026-N2_Horizon_VM.md — ред. rev.01 v02: срок 120 к.д. от подписания, заказчик ООО «ТМ ТЕХНОЛОГИЯ», этапы и платежи по Решению №2 (аванс 1 55% = 1 610 000,00 / ав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
2026-10-26 docs: переписка — реестры и письмо М1 (отправлено 26.10.2026); манифест v1.3, план-график v03, журнал 1.7/4.7
    Переписка (новый контур ИРП `01__Документация\Переписка\`):
    - развернуты каталоги 01__Входящие / 02__Исходящие / 03__Третьи лица /
    04__Не официальная с реестрами-заглушками README-mail-*.md и `00__draft\`;
    регламент кодифицирован в `AGENTS.md` § 10 (промт стороны от 26.10.2026);
    - письмо «О старте работ» Исх. № 8/2026-N2-Горизонт-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
2026-10-29 docs(N2): переэкспорт Спецификации №2 и черновик docx в 00__draft
    - Удалён прежний nosign-pdf (#08_2026-n2-горизонт), добавлен переэкспортированный
    (_08_2026-n2-горизонт nosign.pdf) — выпуск ТКП после корректировок мастера
    - 02__Участники\00__draft\ — исходный docx спецификации (черновая версия,
    по аналогии с 00__draft в рамке N0)
    - .gitignore: desktop.ini
